Mateushga1/Buck-Boost-Converter/Readme.md

# 8V–56V Selectable Buck–Boost/Buck Regulator with Opto-Isolated 0V-5V/4mA-20mA Control Signal

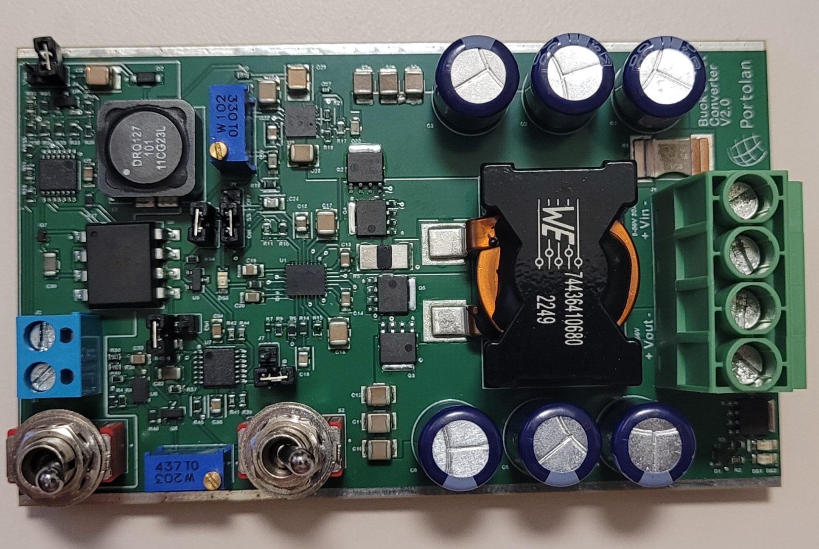
[picture p1: Manual/figures/PCB_Real.jpg]
PCB Image
