Mateushga1/Buck-Boost-Converter/_deprecated-V1/Simulation_Buck_Boost.pdf

# Projet Portolan

### Données de Simulation du Convertisseur Buck-Boost

### Mateus GALVÃO

Janvier 2024

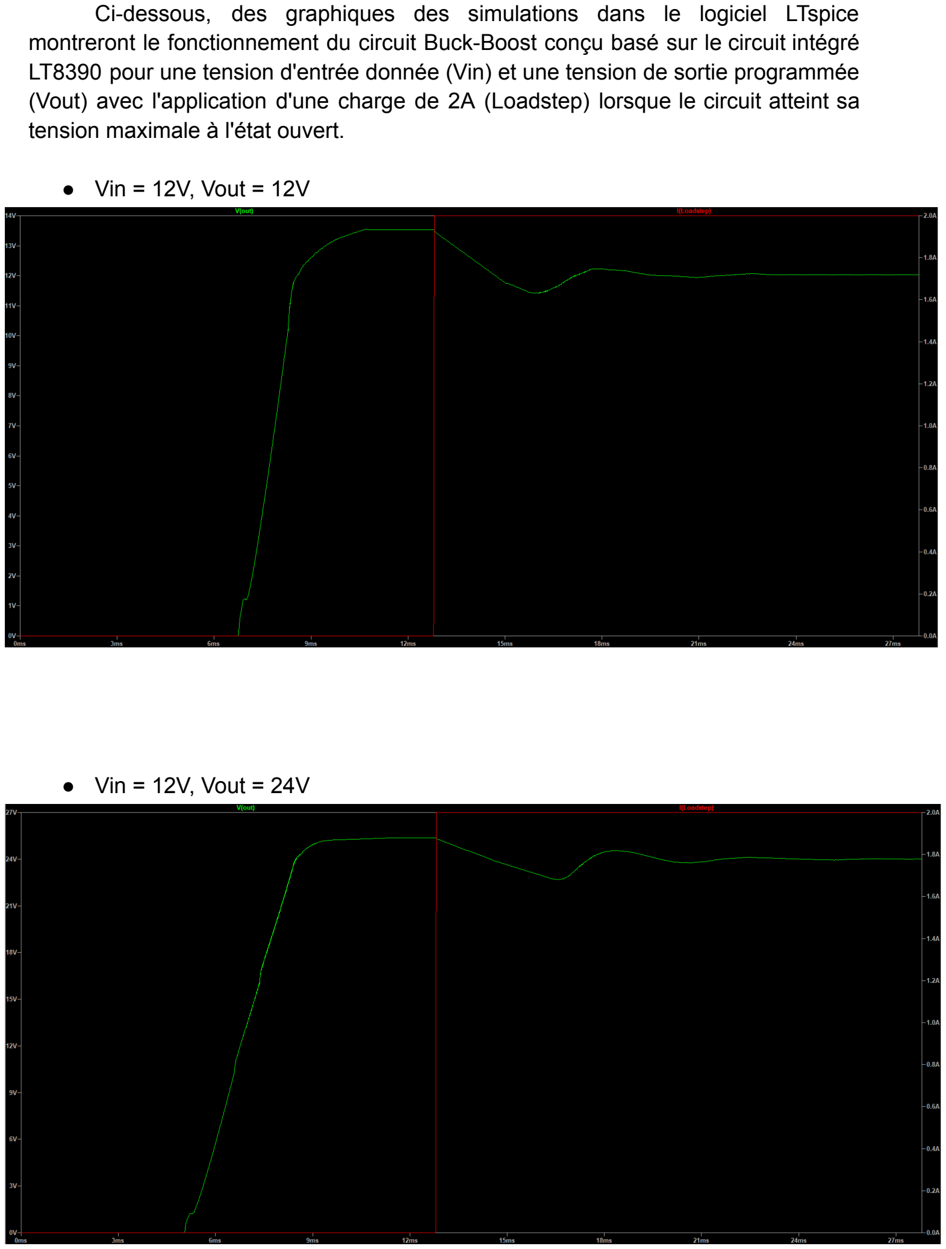
[picture p9: page 2]

Ci-dessous, des graphiques des simulations dans le logiciel LTspice montreront le fonctionnement du circuit Buck-Boost conçu basé sur le circuit intégré LT8390 pour une tension d'entrée donnée (Vin) et une tension de sortie programmée (Vout) avec l'application d'une charge de 2A (Loadstep) lorsque le circuit atteint sa tension maximale à l'état ouvert.

- Vin = 12V, Vout = 12V
- Vin = 12V, Vout = 24V

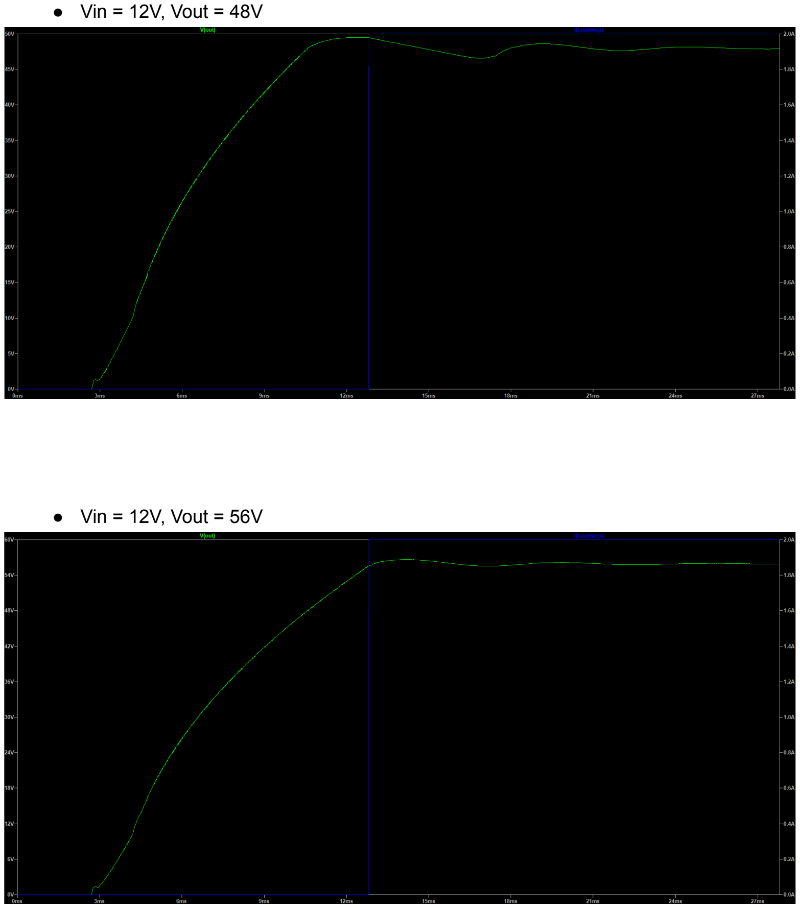
[picture p10: page 3]

- Vin = 12V, Vout = 48V
- Vin = 12V, Vout = 56V

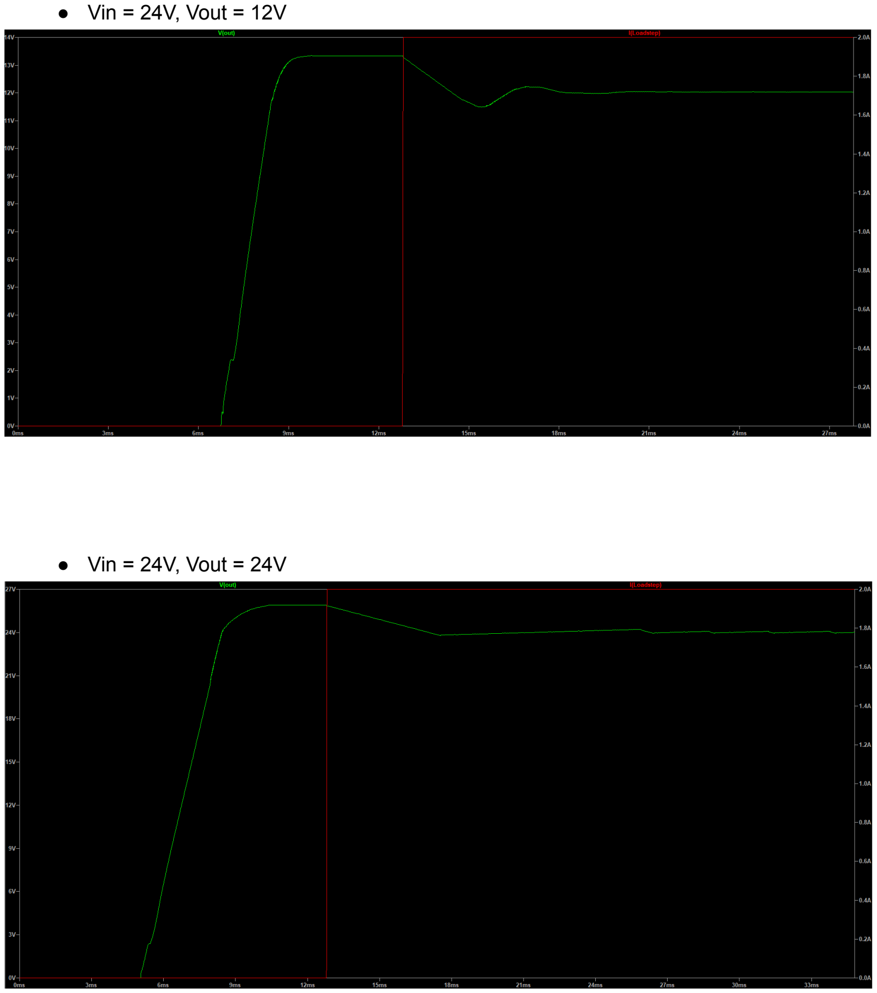
[picture p11: page 4]

- Vin = 24V, Vout = 12V
- Vin = 24V, Vout = 24V

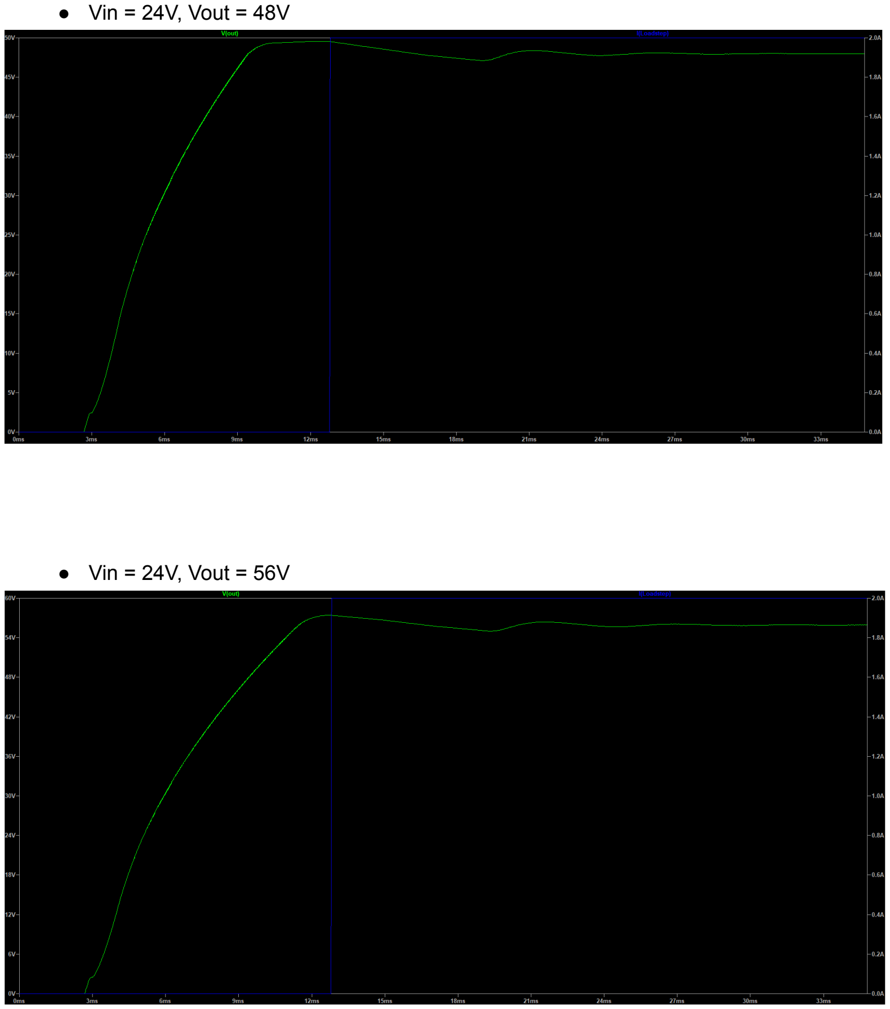
[picture p12: page 5]

- Vin = 24V, Vout = 48V
- Vin = 24V, Vout = 56V

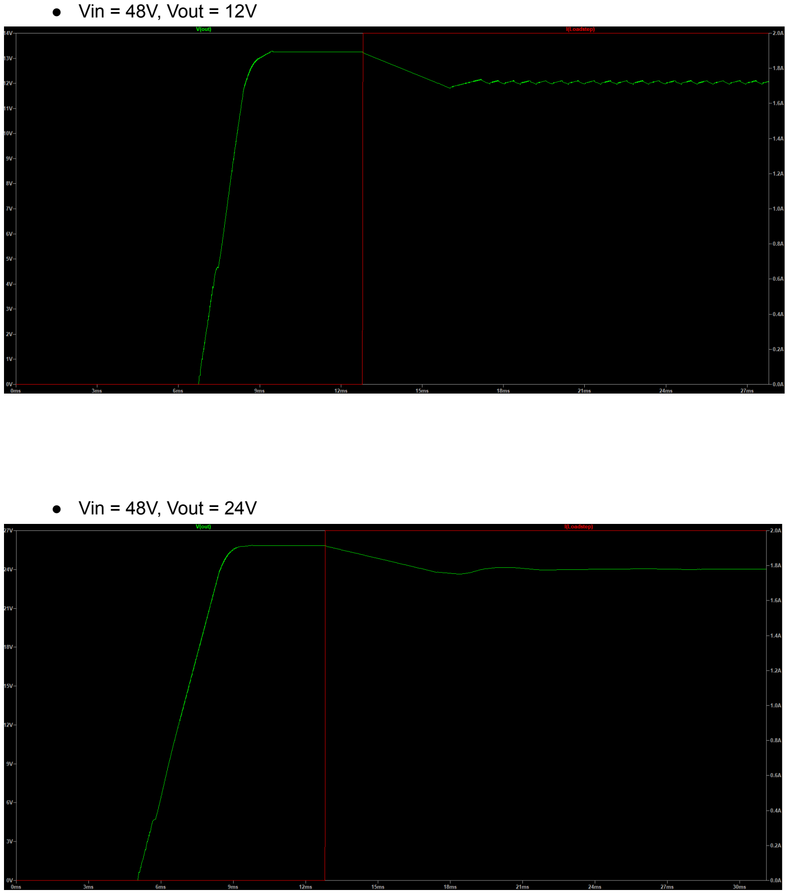
[picture p13: page 6]

- Vin = 48V, Vout = 12V
- Vin = 48V, Vout = 24V

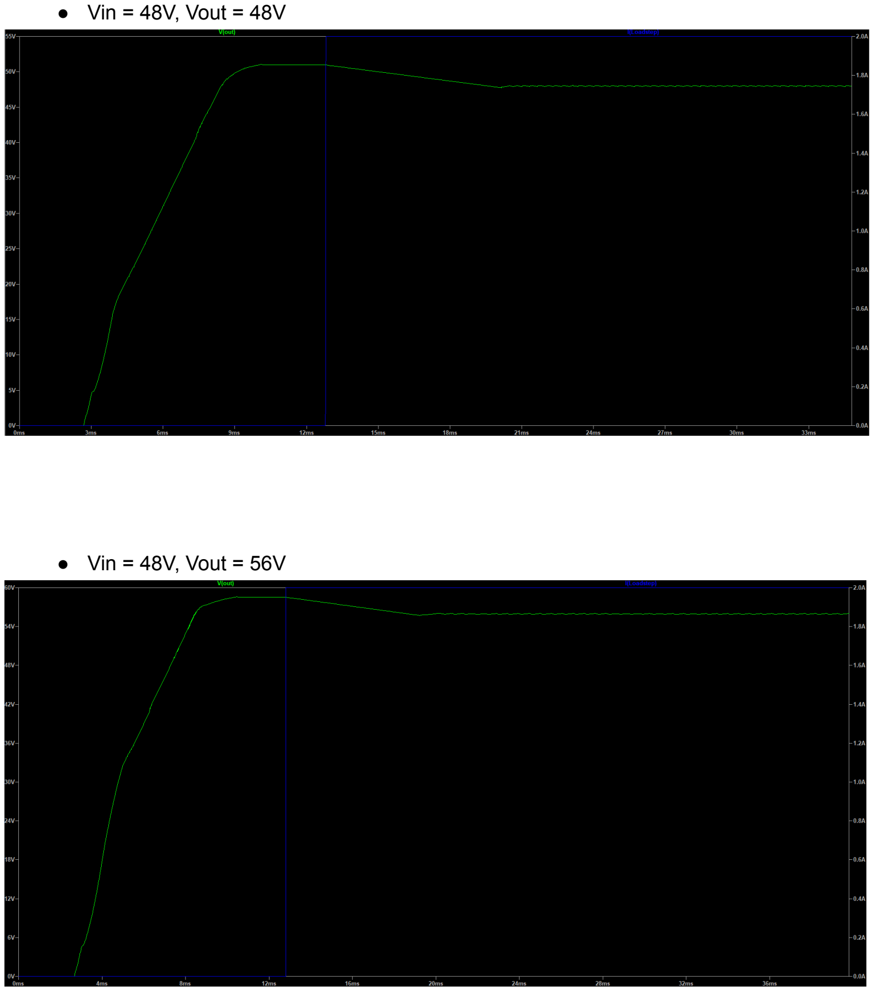
[picture p14: page 7]

- Vin = 48V, Vout = 48V
- Vin = 48V, Vout = 56V

La table ci-dessous présente le taux d'efficacité dans chacune des situations simulées:
