Mateushga1/Buck-Boost-Converter/PCB-V2.jpg

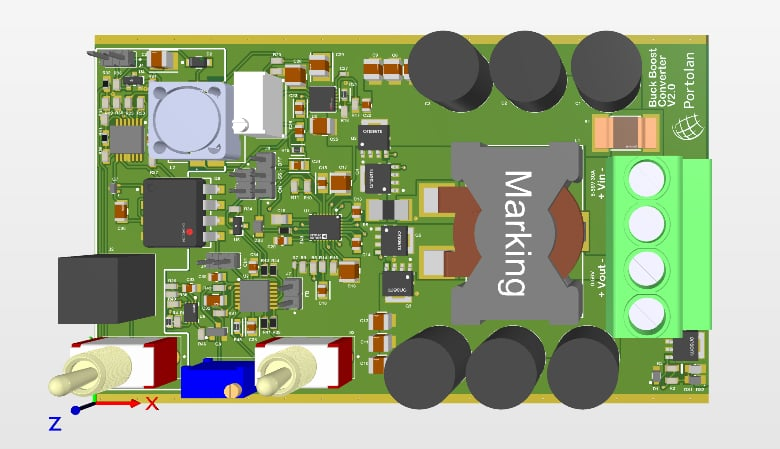
PCB-V2.jpg
