Mateushga1/Buck-Boost-Converter/T-Y10W732956A-1sets-BOM_Portolan_Buck_Boost_V2(2024-12-02).xls

PCBWay Bom Quotation, Product No.:T-Y10W732956A
Item # | *Designator | *Qty | Manufacturer | *Mfg Part # | Description / Value | Vendor Part # | *Package/Footprint | Mounting Type | *Unit Price(1 set) | *Total | *Delivery Time | *PCBWay Note | Customer Reply
1 | C1, C2, C3, C4, C5, C6 | 6 | Panasonic | ECA-2AM101 | ECA-2AM101B『 』Aluminium Electrolytic Capacitors 100uF 100V - Radial Leaded Al Lytic Cap 85C Radial M Series | Farnell『 』9693947 | CAPPRD500W65D1025H1700 | Through Hole | $0.420 | $2.520
2 | C7, C8, C9, C10, C11, C12 | 6 | Murata | GRM32EC72A106KE05L | GRM32EC72A106KE05L『 』Chip Multilayer Ceramic Capacitors for General Purpose, 1210, 10uF, X7S, 22%, 10%, 100V | Farnell『 』3790455 | FP-GRM32E-0_3-0_2-MFG | Surface Mount, MLCC | $0.701 | $4.206
3 | C13, C14, C20, C26, C31, C33, C34, C35 | 8 | Kyocera AVX | 08055C104JAT2A | 08055C104JAT2A『 』General Purpose Ceramic Capacitor, 0805, 100nF, 5%, X7R, 0.15, 50V | Farnell『 』1740673 | 0805 (2012 Metric)『 』FP-0805-L_2_01_0_2-W_1_25-MFG | Surface Mount, MLCC | $0.139 | $1.112
4 | C15 | 1 | KEMET | C0805C475K8PAC | 0805ZD475KAT2A『 』General Purpose Ceramic Capacitor, 0805, 4.7uF, 10%, X5R, 0.15, 10V | Mouser『 』80-C0805C475K8PAC | FP-0805-L_2_01_0_2-W_1_25-IPC_A |  | $0.147 | $0.147
5 | C16, C17, C25, C28 | 4 | Kyocera AVX | 12101C105KAT2A | 12101C105KAT2A『 』General Purpose Ceramic Capacitor, 1210, 1uF, 10%, X7R, 15%, 100V | Farnell『 』1301814 | 1210 (3225 Metric)『 』FP-1210-L_3_3_0_4-W_2_5_0-IPC_C | Surface Mount, MLCC | $0.504 | $2.016
6 | C18, C23, C36 | 3 | Kyocera AVX | 08055C103JAT2A | 08055C103JAT2A『 』General Purpose Ceramic Capacitor, 0805, 10nF, 5%, X7R, 0.15, 50V | Mouser『 』581-08055C103J | 0805 (2012 Metric)『 』FP-0805-L_2_01_0_2-W_1_25-IPC_B | Surface Mount, MLCC | $0.139 | $0.417
7 | C19 | 1 | Kyocera AVX | 08055C474JAT2A | 08055C474JAT2A | Mouser『 』581-08055C474JAT2A | CAPC2013X140X50ML20T25 |  | $0.139 | $0.139
8 | C21, C29 | 2 | Murata | GRM32EC81C476KE15K | GRM32EC81C476KE15K『 』Chip Multilayer Ceramic Capacitors for General Purpose, 1210, 47uF, X6S, 22%, 10%, 16V | Mouser『 』81-GRM32EC81C476KE5K | FP-GRM32E-0_3-0_2-IPC_A |  | $0.488 | $0.976
9 | C22 | 1 | Murata | GRM21AR72A224KAC5L | GRM21AR72A224KAC5L『 』CAP CER 0.22UF 100V X7R 0805 | Digikey『 』490-6461-1-ND | 0805 (2012 Metric)『 』FP-GRM21A-0_1-MFG | Surface Mount, MLCC | $0.164 | $0.164
10 | C24 | 1 | Murata | GRM2195C1H512JA01D | GRM2195C1H512JA01D『 』Chip Multilayer Ceramic Capacitors for General Purpose, 0805, 5100pF, C0G, 30ppm/°C, 5%, 50V | Mouser『 』81-GRM2195C1H512JA1D | 0805 (2012 Metric)『 』FP-GRM219-0_1-IPC_A | Surface Mount, MLCC | $0.521 | $0.521 | 7-10 Workdays
11 | C27 | 1 | Kyocera AVX | 0402YD273KAT2A | 0402YD273KAT2A | Digikey『 』478-1122-1-ND | 0402 (1005 Metric)『 』CAPC1005X56X25LL10T15 | Surface Mount, MLCC | $0.172 | $0.172
12 | C30, C32 | 2 | Kyocera AVX | 12061A102JAT2A | 12061A102JAT2A『 』General Purpose Ceramic Capacitor, 1206, 1nF, 5%, NP0, 30ppm/°C, 100V | Mouser『 』581-12061A102J | 1206 (3216 Metric)『 』FP-1206-L_3_2_0_2-W_1_6_0-IPC_C | Surface Mount, MLCC | $0.189 | $0.378
13 | D1 | 1 | ON Semiconductor | MM3Z10VST1G | MM3Z10VST1G『 』Zener Voltage Regulator, 300 mW, Tight Tolerance Portfolio, 2-Pin SOD-323, Pb-Free, Tape and Reel | Mouser『 』863-MM3Z10VST1G | ONSC-SOD-323-2-477-02_V | Surface Mount | $0.042 | $0.042
14 | D2 | 1 | ON Semiconductor | MBR230LSFT1G | MBR230LSFT1G『 』DIODE SCHOTTKY 30V 2A SOD123L | Mouser『 』863-MBR230LSFT1G | FP-498-MFG | Surface Mount | $0.157 | $0.157
15 | DS1 | 1 | Vishay Lite-On | LTST-C170KRKT | LTST-C170KRKT『 』LED Red, 75 mW, 54 mcd, -55 to 85 degC, 2-Pin SMD, RoHS, Tape and Reel | Digikey『 』160-1415-1-ND | LTST-C170KRKT_V | Surface Mount | $0.586 | $0.586
16 | DS2, DS3 | 2 | Vishay Lite-On | LTST-C170KGKT | LTST-C170KGKT『 』Ultra Bright AlInGaP Chip LED, 75 mW, -55 to 85 degC, 2-Pin SMD (0805), RoHS, Tape and Reel | Mouser『 』859-LTST-C170KGKT | LTST-LTST-C170KGKT-2_V |  | $0.019 | $0.038
17 | J1 | 1 | Phoenix Contact | 1777561 | 1777561『 』Connector | Mouser『 』651-1777561 | 1777561 | Through Hole | $5.551 | $5.551 | 7-10 Workdays
18 | J2 | 1 | CUI Devices | TB001-500-02BE | TB001-500-02BE『 』Integrated Circuit | Mouser『 』490-TB001-500-02BE | TB00150002BE | Through Hole | $0.846 | $0.846 | 7-10 Workdays
19 | J3 | 1 | Molex | 22-28-4030 | 22-28-4030『 』Connector Header Through Hole 3 position 0.100 (2.54mm) | Mouser『 』538-22-28-4030 | MOLEX_22-28-4030 |  | $0.320 | $0.320 | 7-10 Workdays
20 | J4, J5, J6, J7 | 4 | Molex | 22-28-4020 | 22-28-4020『 』Connector Header Through Hole 2 position 0.100 (2.54mm) | Farnell『 』2751448 | MOLEX_22-28-4020 |  | $0.222 | $0.888 | 7-10 Workdays
21 | L1 | 1 | Wurth Electronics | 74436410680 | 74436410680『 』74436410680 Inductor, high current, 6.8uH, 1.44mOhm, 27mmL x 28mmW x 15.4mmH, SMT | Wurth Electronics 74436410680 | Digikey『 』732-11532-ND | WE-HCF_2815 | Surface Mount | $9.997 | $9.997
22 | L2 | 1 | Eaton Bussmann | DRQ127-101-R | DRQ127-101-R『 』Inductor | Mouser『 』704-DRQ127-101-R | DRQ127101R | Surface Mount | $2.029 | $2.029 | 7-10 Workdays
23 | Q1, Q2, Q3, Q4, Q5 | 5 | ON Semiconductor | NVMYS3D3N06CLTWG | NVMYS3D3N06CLTWG『 』NVMYS3D3N06CLTWG Single Mosfet Transistors Rohs Compliant: Yes |Onsemi NVMYS3D3N06CLTWG | Mouser『 』863-NVMYS3D3N06CLTWG | FP-760AB-MFG | Surface Mount | $1.858 | $9.290 | 7-10 Workdays
24 | Q6 | 1 | Broadcom Avago | HCNR200-500E | HCNR200-500E『 』OPTOISO 5KV LINEAR PHVOLT 8DIPGW | Mouser『 』630-HCNR200-500E | FP-HCNR200-500E-MFG | Surface Mount | $1.570 | $1.570
25 | Q7 | 1 | ON Semiconductor | MMBT3906TT1G | MMBT3906TT1G『 』General Purpose Transistor, PNP Silicon, 3-Pin SC-75, Pb-Free, Tape and Reel | Digikey『 』MMBT3906TT1GOSCT-ND | ONSC-SC-75-3-463-01_V | Surface Mount | $0.050 | $0.050
26 | Q8 | 1 | ON Semiconductor | MMBT3904LT1G | MMBT3904LT1G『 』General Purpose Transistor, NPN Silicon, 3-Pin SOT-23, Pb-Free, Tape and Reel | Mouser『 』863-MMBT3904LT1G | ONSC-SOT-23-3-318-08_V | Surface Mount | $0.454 | $0.454
27 | R1 | 1 | Bourns | CSS2H-3920K-3L00FE | CSS2H-3920K-3L00FE『 』RES 0.003 OHM 1% 5W 3920 | Farnell『 』4036977 | FP-CSS2H-3920K-3L00FE-MFG |  | $1.764 | $1.764 | 7-10 Workdays
28 | R2 | 1 | Yageo | RC0603FR-073K32L | ERJ-3EKF3321V | Mouser『 』603-RC0603FR-073K32L | 0603 (1608 Metric)『 』RESC1608X55X30NL15T15 |  | $0.152 | $0.152 |  | The quoted part number is [RC0603FR-073K32L], not [ERJ-3EKF3321V] as specified in description.Please confirm. | The part number is correct, you can disconsider the description
29 | R3, R15, R23, R25, R26, R29, R30 | 7 | Panasonic | ERJ-3EKF1003V | ERJ-3EKF1003V | Mouser『 』667-ERJ-3EKF1003V | 0603 (1608 Metric)『 』RESC1608X55X30ML15T15 |  | $0.046 | $0.322
30 | R4 | 1 | Panasonic | ERJ-3EKF1873V | ERJ-3EKF1873V『 』RES SMD 187K OHM 1% 1/10W 0603 | Digikey『 』P187KHCT-ND | 0603 (1608 Metric)『 』FP-ERJ3EK-MFG |  | $0.046 | $0.046
31 | R5 | 1 | Vishay | WSLP25121L600FEA | WSLP25121L600FEA『 』Current Sense Resistors - SMD 3watt .0016ohm 1% | Mouser『 』71-WSLP25121L600FEA | 2512 (6432 Metric)『 』RESC6432X89N |  | $1.373 | $1.373 | 7-10 Workdays
32 | R6 | 1 | Panasonic | ERJ-3EKF8203V | ERJ3EKF8203V | Mouser『 』667-ERJ-3EKF8203V | 0603 (1608 Metric)『 』RESC1608X55X30ML15T15 |  | $0.046 | $0.046
33 | R7 | 1 | Panasonic | ERJ-2RKF7322X | ERJ-2RKF7322X | Mouser『 』667-ERJ-2RKF7322X | 0402 (1005 Metric)『 』RESC1005X40X25LL05T05 |  | $0.046 | $0.046
34 | R8 | 1 | Panasonic | ERJ-3EKF3401V | ERJ-3EKF3401V | Digikey『 』P3.40KHCT-ND | 0603 (1608 Metric)『 』RESC1608X55X30LL15T15 |  | $0.046 | $0.046
35 | R9 | 1 | Panasonic | ERJ-3EKF1872V | ERJ-3EKF1872V | Mouser『 』667-ERJ-3EKF1872V | 0603 (1608 Metric)『 』RESC1608X55X30LL15T15 |  | $0.046 | $0.046
36 | R10 | 1 | Panasonic | ERJ-3EKF2493V | ERJ-3EKF2493V | Digikey『 』P249KHCT-ND | 0603 (1608 Metric)『 』RESC1608X55X30ML15T15 |  | $0.046 | $0.046
37 | R11 | 1 | Bourns | CR0603-FX-4532ELF | ERJ-3EKF4532V | Mouser『 』652-CR0603-FX4532ELF | 0603 (1608 Metric)『 』RESC1608X55X30ML15T15 |  | $0.042 | $0.042 |  | The quoted part number is [CR0603-FX-4532ELF], not [ERJ-3EKF4532V] as specified in description.Please confirm. | The part number is correct, you can disconsider the description
38 | R12 | 1 | Panasonic | ERJ-3EKF3300V | ERJ-3EKF3300V『 』Chip Resistor, 330 Ohm, +/- 1%, 0.1 W, -55 to 155 degC, 0603 (1608 Metric), RoHS, Tape and Reel | Mouser『 』667-ERJ-3EKF3300V | 0603 (1608 Metric)『 』RESC1608X55X30LL15T15 |  | $0.046 | $0.046
39 | R14 | 1 | Panasonic | ERJ-3EKF2201V | ERJ3EKF2201V | Mouser『 』667-ERJ-3EKF2201V | 0603 (1608 Metric)『 』RESC1608X55X30LL15T15 |  | $0.046 | $0.046
40 | R17 | 1 | Yageo | RC0603FR-07162KL | ERJ-3EKF1623V | Digikey『 』311-162KHRCT-ND | 0603 (1608 Metric)『 』RESC1608X55X30ML15T15 |  | $0.154 | $0.154 |  | The quoted part number is [RC0603FR-07162KL], not [ERJ-3EKF1623V] as specified in description.Please confirm. | The part number is correct, you can disconsider the description
41 | R18 | 1 | Panasonic | ERJ-3EKF1333V | ERJ-3EKF1333V | Digikey『 』P133KHCT-ND | 0603 (1608 Metric)『 』RESC1608X55X30LL15T15 |  | $0.042 | $0.042
42 | R19 | 1 | Panasonic | ERJ-3EKF1302V | ERJ-3EKF1302V『 』RES SMD 13K OHM 1% 1/10W 0603 | Digikey『 』P13.0KHCT-ND | 0603 (1608 Metric)『 』FP-ERJ3EK-IPC_C |  | $0.042 | $0.042
43 | R20 | 1 | Bourns | CR0603-FX-3571ELF | ERJ-3EKF3571V | Mouser『 』652-CR0603FX-3571ELF | 0603 (1608 Metric)『 』RESC1608X55X30LL15T15 |  | $0.042 | $0.042
44 | R21 | 1 | Panasonic | ERJ-3EKF2372V | ERJ-3EKF2372V『 』RES SMD 23.7K OHM 1% 1/10W 0603 | Digikey『 』P23.7KHCT-ND | 0603 (1608 Metric)『 』FP-ERJ3EK-IPC_C |  | $0.046 | $0.046
45 | R22 | 1 | Panasonic | ERJ-3EKF2001V | ERJ-3EKF2001V | Digikey『 』P2.00KHCT-ND | 0603 (1608 Metric)『 』RESC1608X55X30ML15T15 |  | $0.046 | $0.046
46 | R24 | 1 | Panasonic | ERJ-3EKF2002V | ERJ-3EKF2002V | Digikey『 』P20.0KHCT-ND | 0603 (1608 Metric)『 』RESC1608X55X30ML15T15 |  | $0.046 | $0.046
47 | R27 | 1 | Panasonic | ERJ-3EKF1500V | ERJ-3EKF1500V | Digikey『 』P150HCT-ND | 0603 (1608 Metric)『 』RESC1608X55X30NL15T15 |  | $0.046 | $0.046
48 | R28 | 1 | Panasonic | ERJ-3EKF5111V | ERJ-3EKF5111V | Mouser『 』667-ERJ-3EKF5111V | 0603 (1608 Metric)『 』RESC1608X55X30LL15T15 |  | $0.046 | $0.046
49 | R31, R32 | 2 | Yageo | RT0603BRE07250RL | 250R『 』Thin Film Resistors - SMD 250 ohm 0.1% 50 ppm High-Precision RT0603BRE07250RL | Digikey『 』13-RT0603BRE07250RLCT-ND | 0603 (1608 Metric)『 』RESC1608X55N |  | $0.147 | $0.294
50 | R33, R43, R46 | 3 | Panasonic | ERJ-3EKF1001V | ERJ-3EKF1001V | Mouser『 』667-ERJ-3EKF1001V | 0603 (1608 Metric)『 』RESC1608X55X30LL15T15 |  | $0.046 | $0.138
51 | R34, R35 | 2 | Panasonic | ERJ-3EKF7680V | ERJ-3EKF7680V | Mouser『 』667-ERJ-3EKF7680V | 0603 (1608 Metric)『 』RESC1608X55X30LL15T15 |  | $0.046 | $0.092
52 | R36 | 1 | Yageo | RC0603FR-071ML | RC0603FR-071ML『 』Chip Resistor, 1 MOhm, +/- 1%, 100 mW, -55 to 155 degC, 0603 (1608 Metric), RoHS, Tape and Reel | Digikey『 』311-1.00MHRCT-ND | 0603 (1608 Metric)『 』RESC1608X55X25LL10T15 |  | $0.154 | $0.154
53 | R37 | 1 | Panasonic | ERJ-3EKF9092V | ERJ-3EKF9092V | Digikey『 』P90.9KHCT-ND | 0603 (1608 Metric)『 』RESC1608X55X30ML15T15 |  | $0.046 | $0.046
54 | R38 | 1 | Bourns | CR0603-FX-2803ELF | ERJ-3EKF2803V | Mouser『 』652-CR0603-FX2803ELF | 0603 (1608 Metric)『 』RESC1608X55X30LL15T15 |  | $0.042 | $0.042 |  | The quoted part number is [CR0603-FX-2803ELF], not [ERJ-3EKF2803V] as specified in description.Please confirm. | The part number is correct, you can disconsider the description
55 | R39, R41, R42, R44 | 4 | Bourns | CR0603-FX-1002ELF | ERJ3EKF1002V『 』Chip Resistor, 10 KOhm, +/- 1%, 0.1 W, -55 to 155 degC, 0603 (1608 Metric), RoHS, Tape and Reel | Mouser『 』652-CR0603FX-1002ELF | 0603 (1608 Metric)『 』RESC1609X55X30LL15T15 |  | $0.042 | $0.168 |  | The quoted part number is [CR0603-FX-1002ELF], not [ERJ3EKF1002V] as specified in description | The part number is correct, you can disconsider the description
56 | R40 | 1 | Panasonic | ERJ-3EKF7502V | ERJ-3EKF7502V | Digikey『 』P75.0KHCT-ND | 0603 (1608 Metric)『 』RESC1608X55X30NL15T15 |  | $0.046 | $0.046
57 | R45 | 1 | Panasonic | ERJ-3EKF4993V | ERJ-3EKF4993V『 』RES SMD 499K OHM 1% 1/10W 0603 | Digikey『 』P499KHCT-ND | FP-ERJ3EK-IPC_B |  | $0.046 | $0.046
58 | S1, S2 | 2 | E-Switch | 100SP1T1B1M2QEH | 100SP1T1B1M2QEH『 』Switch | Farnell『 』4050975 | 100SP1T1B4M2QE |  |  |  |  | [DNP不要贴]; | You can leave it without the part, I can solder it when the PCB arrives
59 | U1 | 1 | Analog Devices / Linear Technology | LT8390EUFD#PBF | LT8390EUFD#PBF『 』IC REG CTRLR BUCK/BOOST 28QFN | Farnell『 』4026327 | FP-UFD-28-05-08-1712-MFG | Surface Mount | $17.265 | $17.265 | 7-10 Workdays
60 | U2 | 1 | Texas Instruments | LM5160DNTT | LM5160DNTT『 』IC REG BCK FLYBCK ADJ 12WSON | Digikey『 』296-38543-1-ND | FP-DNT0012B-MFG | Surface Mount | $2.516 | $2.516
61 | U3, U7 | 2 | Analog Devices | AD8534ARUZ-REEL | AD8534ARUZ-REEL『 』Quad Channel Rail-to-Rail Operational Amplifier, 3 MHz BW, 5 V/us SR, Industrial, 14-pin SOP (RU-14), Reel | Farnell『 』4019796 | ADI-RU-14_L | Surface Mount | $1.688 | $3.376
62 | U4, U5 | 2 | Microchip | LM4040CYM3-5.0-TR | LM4040CYM3-5.0-TR『 』LM4040CYM3-5.0-TR LM4040 Series 5 V ±0.5% Precision Micropower Shunt Voltage Reference-SOT-23-3 | Farnell『 』2775054 | FP-SOT23-3LD-PL-1-MFG | Surface Mount | $0.683 | $1.366
63 | U6 | 1 | Analog Devices / Linear Technology | LTC6992CDCB-1#TRMPBF | LTC6992CDCB-1#TRMPBF『 』IC OSC SILICON PROG 6-DFN | Farnell『 』4023646 | FP-DCB-6-05-08-1715-MFG | Surface Mount | $7.328 | $7.328 | 7-10 Workdays | The quoted part number is [LTC6992CDCB-1#TRMPBF], not [PROG] as specified in description | The part number is correct, you can disconsider the description
64 | VR1 | 1 | Bourns | 3296W-1-102LF | 3296W-1-102LF『 』Square Trimpot(R) Trimming Potentiometer, 1000 Ohm, -55 to 125 degC, 3-Pin THD, RoHS, Tube | Mouser『 』652-3296W-1-102LF | BOUR-3296W-1-3 | Through Hole | $0.856 | $0.856
65 | VR2 | 1 | Bourns | 3296W-1-203LF | 3296W-1-203LF『 』Trimmer Resistors - Through Hole 3/8 20Kohms Sealed Vertical Adjust | Mouser『 』652-3296W-1-203LF | TRIM_3296W-1-203LF |  | $0.801 | $0.801
66 | J3,J4,J5,J6,J7 | 5 |  | QPC02SXGN-RC | 2 (1 x 2) Position Shunt Connector Black Open Top 0.100" (2.54mm) Gold |  |  |  | $0.159 | $0.795 | 7-10 Workdays | 5pcs QPC02SXGN-RC will be used on this board.
 |  |  |  |  |  |  |  |  | Component Cost | $84.45
 |  |  |  |  |  |  |  |  | Assembly Cost | $29.00
 |  |  |  |  |  |  |  |  | PCB Cost | $0.00
 |  |  |  |  |  |  |  |  | V1 Member 1% off | -$0.29
 |  |  |  |  |  |  |  |  | All Total 1 Sets | $113.16
 |  |  |  |  |  |  |  |  | lead time; 26-28 days
