Mateushga1/Buck-Boost-Converter/Manual/BuckBoost.pdf

LT8390 | Regulateur s ´ | electionnable Buck-Boost ´
a commande opto-isol ` | ee´

Description Gen´ erale ´

Ce projet presente la conception et ´ la realisation d’une carte convertisseur ´ DC-DC compacte et haute performance,
basee sur le contr ´ | oleur synchrone ˆ | a 4 in- `
terrupteurs LT8390 de Linear Technology. La carte accepte une large plage de tensions d’entree (8 V-56 V) et fournit une ´
sortie reglable de 0 V ´ | a 56 V en mode `
Buck-Boost ou jusqu’a Vin en mode Buck, ` avec controle de courant cycle-par-cycle ˆ
jusqu’a 30 A en entr ` | ee et rendements de ´
crete sup ˆ | erieurs ´ | a 93 %. `

Les blocs fonctionnels cles comprennent : ´
une etage Buck-Boost int ´ | egr ´ e, une protec- ´
tion contre l’inversion de polarite´ a base ` de MOSFET, un convertisseur auxiliaire Fly-Buck (LM5160A) fournissant des rails
5 V isoles et non isol ´ | es, une interface ´
de controle externe galvanique isol ˆ | ee (0- ´
5 V ou 4-20 mA) basee sur l’optocoupleur ´ HCNR200, et un reseau programmable ´ de selection de mode et d’injection de ´ retroaction (utilisant un PWM LTC6992 ´ pour l’echelle Buck). ´

Le cycle complet de developpement a ´
et ´ e r ´ ealis ´ | e : d ´ | efinition de la topologie et ´
dimensionnement des composants selon les datasheets, modelisation LTspice, im- ´ plantation du PCB sous Altium, et validation en banc des etages de puissance et ´ des boucles de controle. ˆ

Avantages et Caracteristiques ´

- Plage de tension d’entree´ etendue (8V- ´ 56V).
- Topologie | synchrone | 4 | interrupteurs
LT8390.
- Rendement ¡ 93%.
- Protection contre inversion de polarite par ´ MOSFET avec indication LED visuelle.
- Convertisseur auxiliaire Fly-Buck four-
nissant des rails 5 V isoles et non isol ´ | es. ´
- Controle externe galvanique isol ˆ | e via op- ´
tocoupleur haute linearit ´ | e.´
- Interface | de | commande | externe
selectionnable (0-5 V ou 4-20 mA). ´
- Selection dynamique du mode entre ´ Buck-Boost (0 V-56 V en sortie) et Buck (0 V-Vin en sortie).
- Limitation de courant cycle-par-cycle
(resistance de d ´ | etection 1,6 m ´ | Ω), UVLO
(¡ 8 V) et demarrage progressif pour ´ protection robuste.
- Modulation de frequence ´ | a Spread Spec- `
trum pour reduire les EMI. ´
- PCB compact 2 couches a haute densit ` | e´
de composants.

Revision 1 - Juin 2025 ´

## 1 Outils Utilises´

Pour le developpement complet de ce projet, trois outils principaux ont ´ | et´ e utilis ´ | es´
: LTspice, LTpowerCAD et Altium Designer. Chacun d’eux joue un role fondamental ˆ | a`
differentes ´ | etapes du processus de cr ´ | eation, depuis la simulation et le dimensionnement ´
initial des composants jusqu’a l’ ` elaboration des sch ´ | emas et du circuit imprim ´ | e (PCB). ´
LTspice est un simulateur SPICE de circuits electroniques gratuit, fourni par Analog ´ Devices. Il permet de modeliser des transistors, diodes, inductances, condensateurs et ´
de nombreux autres composants electroniques, en r ´ | ealisant des analyses dans le do- ´
maine temporel (transitoires), frequentiel (balayage AC) et en point de fonctionnement ´
(point DC), entre autres. Dans le cadre de ce projet, LTspice a et´ e utilis ´ | e pour simuler ´
tous les sous-circuits conc¸us. Grace ˆ | a ces simulations, il a ` | et´ e possible d’observer les ´
formes d’onde de commutation, d’analyser les ondulations de tension et de courant, d’estimer les rendements et de valider les circuits de protection avant l’assemblage
physique de la carte. L’outil a egalement facilit ´ | e l’ajustement des valeurs des induc- ´
tances, resistances de d ´ | etection et fr ´ | equences de commutation, rendant le processus de ´
dimensionnement plus efficace et precis. La simulation a permis d’identifier d’ ´ | eventuels ´
problemes de stabilit ` | e et de bruit, permettant ainsi des ajustements avant la fabrication ´
du prototype. Cependant, elle ne permet pas de valider les protections contre les in-
terferences ´ | electromagn ´ | etiques (EMI) et la compatibilit ´ | e´ electromagn ´ | etique (EMC), qui ´
sont extremement difficiles ˆ | a` evaluer sans la r ´ | ealisation physique du circuit. ´
LTpowerCAD est un logiciel d’aide a la conception de r ` | egulateurs de puissance, ´
egalement propos ´ | e par Analog Devices. Cet outil automatise le dimensionnement initial ´
des convertisseurs DC/DC, en suggerant des valeurs pour les inductances, conden- ´
sateurs, MOSFETs et resistances de r ´ | etroaction en fonction des param ´ | etres d’entr ` | ee´
(tension d’alimentation, tension de sortie desir ´ | ee, courant de charge, fr ´ | equence de ´
commutation, entre autres). Pour le convertisseur buck-boost principal, LTpowerCAD
a et ´ e utilis ´ | e pour g ´ | en´ erer une conception de base, en d ´ | efinissant des valeurs approx- ´
imatives d’inductance, de capacite et de composants de contr ´ | ole recommand ˆ | es par le ´
fabricant du LT8390. A partir de cette base, les param ` | etres ont ` | et´ e affin ´ | es dans LTspice, ´
garantissant que les aspects theoriques et pratiques du projet respectaient les crit ´ | eres `
d’efficacite, de stabilit ´ | e et de robustesse d ´ | efinis dans la fiche technique. ´
Enfin, Altium Designer a et ´ e l’outil choisi pour le d ´ | eveloppement du sch ´ | ema com- ´
plet et de la carte de circuit imprime (PCB). Altium Designer est un environnement de ´
conception assistee par ordinateur (CAO) d ´ | edi ´ e´ a l’ ` electronique, permettant de dessiner ´
les schemas, cr ´ | eer des biblioth ´ | eques de composants, d ` | efinir les r ´ | egles de conception `
(design rules) et realiser des layouts de cartes avec des fonctions avanc ´ | ees de routage, ´
d’analyse d’integrit ´ | e du signal et de v ´ | erification d’imp ´ | edance. Dans le cadre de ce projet, ´
Altium Designer a permis la capture schematique de tous les sous-circuits, la connex- ´ ion des signaux d’alimentation et de commande, l’insertion de composants specifiques ´ (LT8390, LM5160A, optocoupleurs, MOSFETs, etc.), et ensuite la gen´ eration du PCB ´ avec un empilement de couches approprie, la d ´ efinition des vias, des plans de cuivre ´

pour l’alimentation et des zones de masse optimisees. De plus, Altium a g ´ | en´ er´ e les ´
fichiers de fabrication (Gerber, NC Drill et listes de materiaux) n ´ | ecessaires ´ | a la produc- `
tion du prototype, assurant que le projet respecte les bonnes pratiques de routage et les exigences de fabrication industrielle.

## 2 Sous-circuits

Dans cette section, sont present ´ | es les principaux blocs qui composent la carte : (1) ´
le convertisseur Buck-Boost base sur le LT8390, charg ´ | e de la conversion DC/DC de ´
la tension d’entree vers la tension de sortie d ´ | esir ´ | ee , (2) le circuit de protection con- ´
tre l’inversion de polarite, qui emp ´ | eche tout dommage si les c ˆ | ables d’alimentation sont ˆ
inverses , (3) le convertisseur Fly-Buck, qui g ´ | en´ ere les alimentations 5 V n ` | ecessaires ´
aux circuits de commande, tant en zones isolee que non isol ´ | ee , (4) le circuit de signal ´
de commande externe isole, qui rec¸oit et conditionne des signaux 0-5 V ou 4-20 mA ´
de maniere galvanis ` | ee isol ´ | ee , et (5) le circuit de commande et de s ´ | election de mode, ´
charge d’adapter et d’injecter le signal de commande dans la boucle de r ´ | etroaction du ´
LT8390, permettant de choisir entre les modes Buck et Buck-Boost et d’ajuster la tension
de sortie selon la valeur du signal externe. Chaque sous-circuit sera detaill ´ | e ci-apr ´ | es, `
presentant son principe de fonctionnement, le dimensionnement des composants et son ´
integration au syst ´ | eme global. `

### 2.1 Convertisseur Buck-Boost

Le cœur fonctionnel de la carte est constitue par le convertisseur DC-DC en topolo- ´
gie buck-boost, implement ´ | e avec le contr ´ | oleur synchrone LT8390. Comme illustr ˆ | e´ a la `
Figure 1, le LT8390 integre un contr ` | oleur ˆ | a quatre interrupteurs (MOSFETs Q2, Q3, Q4 `
et Q5 sur la Figure 2) autour d’un unique inducteur (L1), autorisant le fonctionnement en mode buck, boost ou buck-boost sans circuits externes supplementaires pour la gestion ´ des transitions de mode. Le dimensionnement de tous les composants (filtres, induc-
teurs, condensateurs de decouplage et r ´ | esistances de d ´ | etection de courant) s’appuie ´
sur les calculs et recommandations du datasheet du LT8390, garantissant que le circuit respecte les exigences de performance et de fiabilite du fabricant. ´

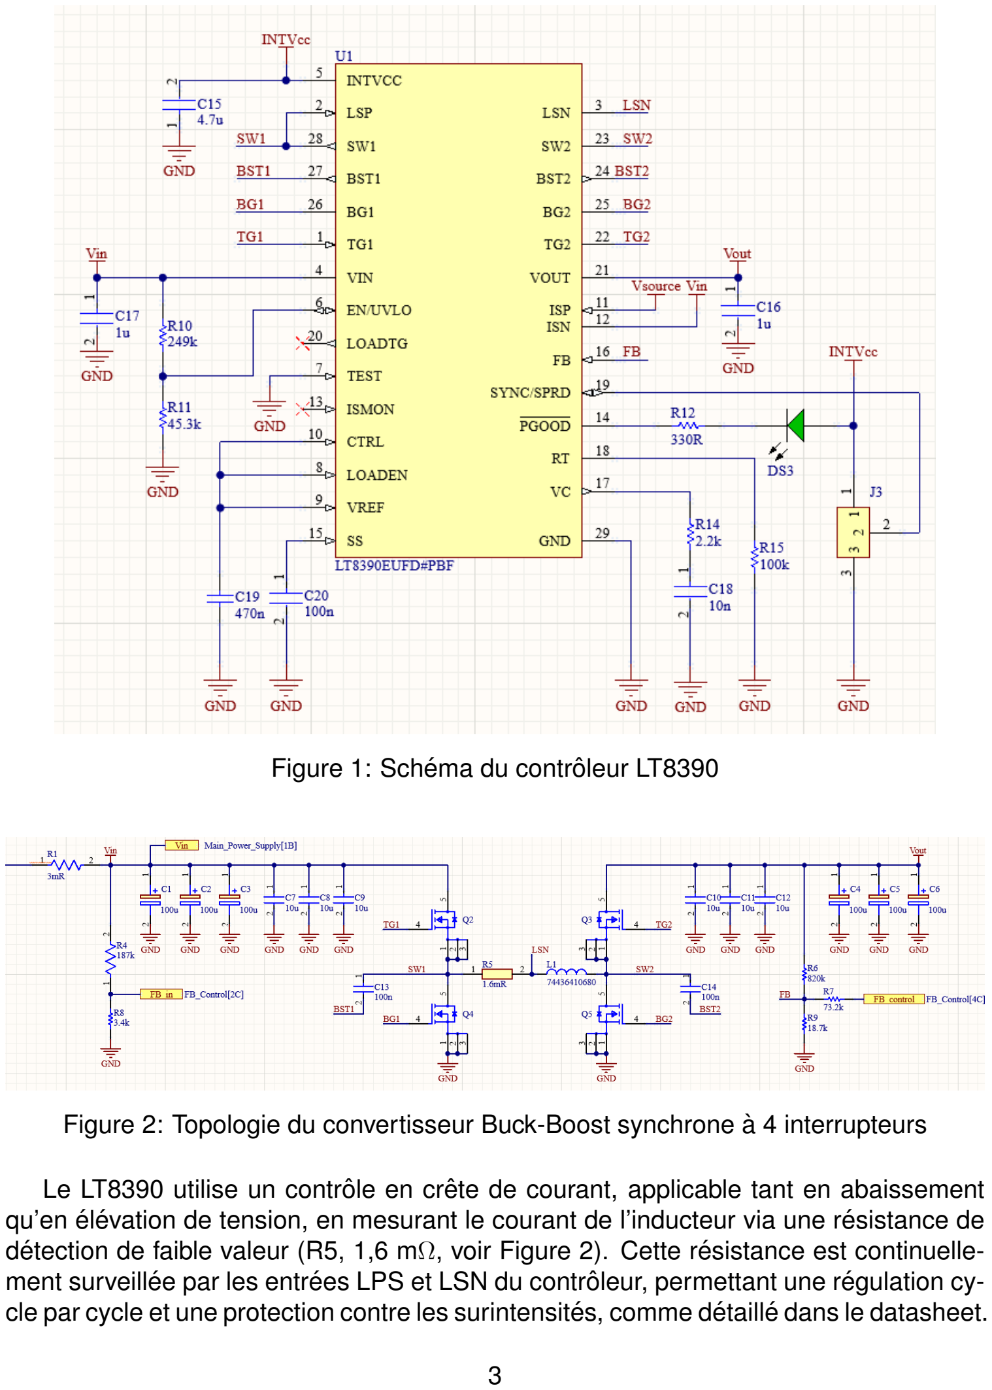
[picture p25: page 4]

Figure 1: Schema du contr ´ | oleur LT8390 ˆ

Figure 2: Topologie du convertisseur Buck-Boost synchrone a 4 interrupteurs `

Le LT8390 utilise un controle en cr ˆ | ete de courant, applicable tant en abaissement ˆ
qu’en el ´ evation de tension, en mesurant le courant de l’inducteur via une r ´ | | | esistance de ´
detection de faible valeur (R5, 1,6 m ´ | | Ω, voir Figure 2). Cette resistance est continuelle- ´
ment surveillee par les entr ´ | ees LPS et LSN du contr ´ | oleur, permettant une r ˆ | egulation cy- ´
cle par cycle et une protection contre les surintensites, comme d ´ | etaill ´ | e dans le datasheet. ´

La precision du contr ´ | ole de courant, associ ˆ | ee´ a la commutation synchrone ` | a haute `
frequence (400 kHz, r ´ | egl ´ ee par la r ´ | esistance R15), offre des rendements sup ´ | erieurs ´
a 95% sur la majeure partie de la plage de fonctionnement, et pouvant atteindre 98% `
selon l’exemple de ref ´ erence du fabricant. Dans ce projet, l’efficacit ´ | e maximale simul ´ | ee´
en conditions optimales a et ´ e de 93%, satisfaisante pour une application aux limites de ´
tension et de courant specifi ´ | ees par le LT8390. ´
Pour attenuer les bruits et interf ´ | erences ´ | electromagn ´ | etiques susceptibles d’induire ´
des signaux parasites sur les pistes voisines, de destabiliser la boucle de r ´ | egulation ´
ou d’emettre vers d’autres ´ | equipements sensibles, le LT8390 int ´ | egre une modulation `
de frequence ´ | a spectre ` | etal ´ | e (spread-spectrum). Plut ´ | ot que de toujours commuter ˆ | a`
une frequence fixe, dont les composantes spectrales concentr ´ | ees risqueraient de vio- ´
ler les normes EMI ou de brouiller des circuits RF voisins, cette modulation fait fluctuer
leg´ erement la fr ` | equence de commutation dans le temps, r ´ | epartissant l’ ´ | energie sur une ´
bande plus large et reduisant ainsi les pics de densit ´ | e spectrale. L’activation de cette ´
fonction s’effectue via le jumper J3 (broche SYNC/SPRD) sur la Figure 1. Dans les appli-
cations ou de faibles pics de bruit peuvent nuire ` | a des circuits analogiques ou des mod- `
ules RF (tel ´ ecommunications, instruments de mesure sensibles), le spread-spectrum ´ est particulierement avantageux. `
Le controleur offre en outre un soft-start (broche SS), une protection UVLO (Under ˆ Voltage Lockout) en cas de sous-tension d’entree, ainsi qu’une protection interne contre ´
les courts-circuits et surcharges, avec possibilite de red ´ | emarrage automatique ou de ´
latch-off, selon le manuel technique du LT8390.
Lors de la phase de conception, un reseau de d ´ | ecouplage et de filtrage a ´ | et´ e mis ´
en place, comportant plusieurs condensateurs en entree et en sortie, essentiel pour ´ limiter le bruit, amortir les transitoires et stabiliser la boucle de regulation. Les valeurs ´
d’inductance et de capacite ont ´ | et ´ e calcul ´ | ees d’apr ´ | es les formules de ripple de courant `
et de tension du datasheet, garantissant que le courant de crete reste en dessous des ˆ limites du fabricant et que la tension de sortie demeure stable meme lors de variations ˆ rapides de charge. Le ripple tensionnel pico-pico maximal projete´ etait de 900 mV pp, ´
d’ou l’emploi de condensateurs d’entr ` | ee (C1, C2, C3, C7, C8, C9) et de sortie (C4, ´
C5, C6, C10, C11, C12) de 10 µF et 100 µF a faible ESR, comme recommand ` | e par le ´
LT8390.
En fonctionnement, le convertisseur accepte une tension d’alimentation de 8 V a` 56 V en entree (broche VIN du LT8390) et se met en veille si la tension descend en ´
dessous de 8 V (grace ˆ | a l’UVLO interne). Le courant d’entr ` | ee maximal projet ´ | e est de ´
30 A, dimensionne par la r ´ | esistance de d ´ | etection et les MOSFETs, pour r ´ | epondre ´ | a`
des charges lourdes. En mode buck-boost, la tension de sortie est reglable entre 0 ´
V et 56 V, tandis qu’en mode buck strict, la sortie varie de 0 V a la tension d’entr ` | ee´
(Vin). La selection du mode s’effectue via un interrupteur d ´ | edi ´ e sur le PCB, mais c’est ´
le LT8390 qui, selon la ref ´ erence de tension pr ´ | esente sur la broche FB (aliment ´ | ee par ´
la commande externe, detaill ´ | ee ult ´ | erieurement), pilote la commutation des MOSFETs ´
pour atteindre la tension desir ´ | ee. Les r ´ | esistances de r ´ | etroaction R6, R7 et R9 (Figure ´

2) definissent le rapport entre la tension de sortie et le signal de feedback, assurant une ´ operation stable sur l’ensemble de la plage 0-56 V. ´

### 2.2 Protection contre l’inversion de polarite´

La protection contre l’inversion de polarite sur cette carte est r ´ | ealis ´ | ee´ a l’aide d’un `
circuit a base de MOSFET, qui bloque tout courant si la source d’alimentation est con- `
nectee´ a l’envers, tout en maintenant des pertes tr ` | es faibles. Cette configuration emp ` | eche ˆ
la tension de sortie d’etre invers ˆ | ee et prot ´ | ege ` | a la fois le convertisseur et les autres blocs `
de la carte en cas d’inversion accidentelle des cables sur les connecteurs d’entr ˆ | ee. ´
Comme illustre´ a la Figure 3, la tension d’entr ` | ee (Vsource) arrive sur le drain du ´
MOSFET Q1 (dont le diode de corps interne est oriente pour bloquer les courants in- ´ verses) et, lorsque la source est correctement connectee, circule vers le reste du circuit ´
avec une chute de tension negligeable gr ´ | ace ˆ | a la faible valeur de ` | RDSponq
. La gate de
Q1 est ref ´ erenc ´ | ee au drain via un pont diviseur et un diode Zener (D1), qui limite la ´
tension VGS pour ne pas depasser la limite s ´ | ure du MOSFET. Dans cette condition de ˆ
polarite correcte, la tension appliqu ´ | ee´ a la gate reste l ` | eg´ erement n ` | egative par rapport ´
a la source (selon le mod ` | ele de MOSFET), forc¸ant Q1 ` | a rester parfaitement satur ` | e. Si- ´
multanement, la LED verte (DS2) s’allume, indiquant ´ | ! alimentation correcte ", car son
anode est relie´ a Vsource et son cathode au point COM. `


Figure 3: Circuit de protection contre l’inversion de polarite´

En cas d’inversion de polarite, la source n ´ | egative se retrouve sur le drain de Q1, ´
mais le diode de corps interne bloque tout passage de courant dans ce sens. De plus,

la tension d’entree invers ´ | ee rend le nœud de gate plus positif que la source, ce qui fait ´
depasser ´ | VGS du seuil de conduction et force Q1 a s’ ` | eteindre compl ´ | etement. Le diode `
Zener D1 garantit que cette surtension sur la gate ne det´ eriore pas le transistor, tandis ´
que la resistance ´ | R3 (en serie avec D1) limite le courant traversant le Zener, maintenant ´
VGS a un niveau s ` | ur. Dans cette situation, la LED rouge (DS1) s’allume, car elle ne ˆ
conduit que lorsque l’entree est invers ´ | ee, signalant ´ | ! polarite incorrecte ´ | ".
En resum ´ | e, le point cl ´ | e de ce sch ´ | ema est la topologie ´ | ! MOSFET inverse´ " : le corps
de Q1 sert de diode de blocage en cas d’inversion, la gate est maintenue a une tension ` qui l’empeche de conduire, et la combinaison d’un pont diviseur et d’un diode Zener ˆ garantit qu’au reconnecter la source correctement, la gate est tiree l ´ eg´ erement sous la ` source, autorisant une conduction normale avec une chute de tension minimale. En d’autres termes, en connexion correcte, le MOSFET conduit sans pertes significatives ,
en connexion inversee, il reste ferm ´ | e, prot ´ | egeant le convertisseur et les circuits en aval. ´
Les LEDs offrent une indication visuelle immediate de l’ ´ | etat de la connexion. ´
Ainsi, le circuit de protection contre l’inversion de polarite utilise un unique MOS- ´
FET a diode de corps interne, une r ` | esistance de gate et un diode Zener pour limiter ´
VGS. Grace ˆ | a cette combinaison, le sch ` | ema assure une protection instantan ´ | ee en cas ´
d’inversion des cables, pr ˆ | esente des pertes de conduction quasi nulles en configuration ´
correcte et indique visuellement le statut de la connexion via des LEDs dedi ´ ees. ´

### 2.3 Sources d’Alimentation Internes de 5V (Convertisseur Fly-Buck)

La carte necessite plusieurs sources d’alimentation basse tension pour ses com- ´
posants de commande, ses tensions de ref´ erence et ses circuits int ´ | egr ´ es (CI), couvrant ´
a la fois la partie isol ` | ee et la partie non isol ´ | ee du syst ´ | eme. Pour r ` | epondre ´ | a ce besoin, `
qui consiste a convertir la haute tension d’entr ` | ee principale du circuit (comprise entre 8 ´
V et 56 V, comme specifi ´ | e par le projet) en niveaux de 5 V, un convertisseur DC/DC en ´
topologie Fly-Buck a et ´ e impl ´ | ement ´ | e. Ce choix est strat ´ | egique, car il permet de g ´ | en´ erer ´
des sorties isolees, ce qui est id ´ | eal pour alimenter des circuits ne devant pas ´ | etre en ˆ
contact direct avec le bus principal, comme le circuit de signal de commande isole. Le ´ cœur de cette solution est le controleur LM5160A de Texas Instruments, un CI robuste ˆ et efficace conc¸u a cet effet. `
Comme illustre´ a la Figure 4, ce circuit constitue la source principale alimentant `
tous les circuits isoles et non isol ´ | es de la carte. Il utilise une topologie d ´ | evelopp ´ | ee par ´
Texas Instruments qui combine les caracteristiques d’un convertisseur Buck, capable ´ d’abaisser une tension d’entree pour en obtenir une autre, et d’un convertisseur Fly- ´
back, ou une tension de sortie isol ` | ee est g ´ | en´ er´ ee´ a partir de l’entr ` | ee. Cet agencement ´
est employe pour r ´ | eduire la tension d’entr ´ | ee, qui peut atteindre 56 V, en deux sources ´
d’alimentation basse tension : une non isolee, destin ´ | ee´ a alimenter tous les composants `
(CI, amplificateurs operationnels, g ´ | en´ eration de signaux de r ´ | ef´ erence), et une isol ´ | ee, ´
dedi ´ ee´ a l’alimentation du circuit de signal de commande isol ` | e. Cette topologie con- ´
stitue une solution tres efficace, capable de fournir toutes les sources n ` | ecessaires pour ´

l’ensemble des sous-systemes de la PCB. De plus, elle offre une haute efficacit ` | e et une ´
faible dissipation de puissance, minimisant l’impact sur l’efficacite globale du convertis- ´ seur Buck-Boost principal.

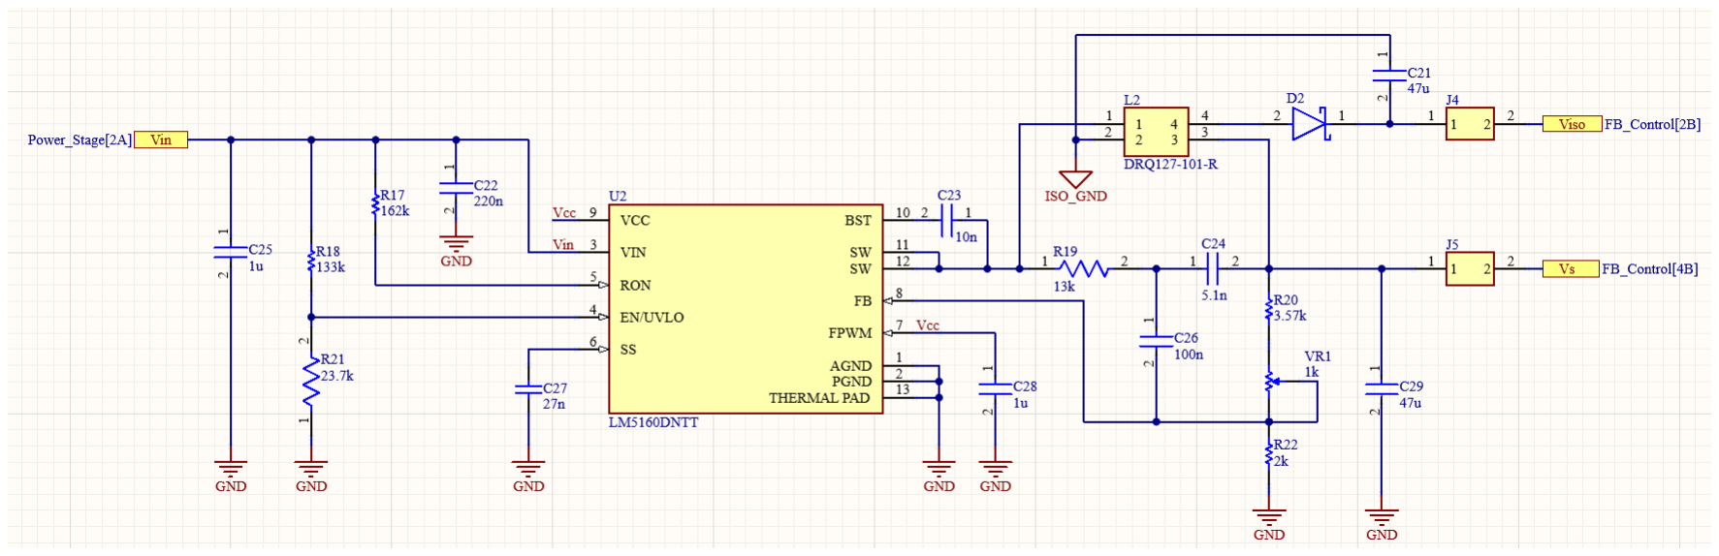
[picture p26: figure]

Figure 4: Schema du Convertisseur Fly-Buck ´

Le circuit d’alimentation interne de 5 V est centre sur le contr ´ | oleur LM5160A de ˆ
Texas Instruments (U2 dans le schema), un convertisseur abaisseur synchrone (step- ´
down) 65 V/2 A qui se distingue par l’integration de MOSFETs haute et basse lat ´ | eral. ´
Cette integration supprime le besoin de diodes Schottky externes pour la rectification, ´
contribuant directement a l’efficacit ` | e en r ´ | eduisant les pertes de conduction et simplifiant ´
la nomenclature (BOM) ainsi que le routage de la carte. Le LM5160A fonctionne selon
un schema de contr ´ | ole en temps de conduction constant adaptatif (COT), qui dispense ˆ
de toute compensation de boucle externe, simplifiant le design et offrant une reponse ´
transitoire rapide. La frequence de commutation, r ´ | eglable par un simple r ´ | esistor, peut ´
atteindre 1 MHz et reste pratiquement constante.
La capacite du LM5160A ´ | a op ` | erer en mode PWM forc ´ | e (FPWM) est essentielle pour ´
son usage en topologie Fly-Buck a sorties multiples, garantissant un transfert d’ ` | energie ´
regulier vers les sorties isol ´ | ees m ´ | eme en cas de faible charge. Le CI int ˆ | egre ` | egalement ´
des protections robustes, telles que la limitation de courant de pic, la protection UVLO
(Under Voltage Lockout) et le declenchement thermique, renforc¸ant la fiabilit ´ | e. La na- ´
ture synchrone du LM5160A, utilisant des MOSFETs plutot que des diodes en basse ˆ
lateral, est cruciale pour l’op ´ | eration Fly-Buck, car une diode bloquerait le courant in- ´
verse n ´ ecessaire pour transf ´ | erer l’ ´ | energie vers la sortie isol ´ | ee. ´
La topologie Fly-Buck est une variante du convertisseur Buck synchrone, ou l’inducteur `
traditionnel est remplace par un inducteur coupl ´ | e (L2 dans le sch ´ | ema) poss ´ | edant plusieurs ´
enroulements. Cette modification permet au circuit non seulement de gen´ erer une sortie ´ non isolee, comme un Buck conventionnel (Vs), mais aussi de produire une ou plusieurs ´
sorties isolees (Viso), de mani ´ | ere analogue ` | a un Flyback. `
La sortie non isolee est g ´ | en´ er´ ee c ´ | otˆ e primaire de l’inducteur coupl ´ | e et est directe- ´
ment regul ´ | ee par la boucle ferm ´ | ee du LM5160A. Sa tension est d ´ | etermin ´ | ee par le rap- ´
port cyclique D et la tension d’entree´ Vin, selon la relation Vout1 D -Vin. Cette sortie
alimente les composants de commande gen´ eraux sur la partie non isol ´ | ee de la carte, ´

le reseau de r ´ | etroaction ´ | etant compos ´ | e de R19, R20, VR1 et R22. La sortie isol ´ | ee´
provient d’un enroulement secondaire de l’inducteur couple. La tension de cette sortie ´
est regul ´ | ee par ´ | ! cross-regulation " via le couplage des enroulements, selon l’expression
approximative Vout2 Vout1 -

pN2{N1q Vf , ou` N1 et N2 sont les nombres de spires et Vf la chute de tension du diode secondaire (D2). Cette sortie est indispensable pour les circuits requerant un isolement galvanique. ´
En termes resum ´ | es, l’op ´ | eration du convertisseur Fly-Buck se divise en deux phases ´
principales, control ˆ ees par la commutation des MOSFETs internes du LM5160A. En ´
mode Ton (High-Side active), la tension d’entr ´ | ee s’applique ´ | a l’enroulement primaire de `
l’inducteur couple, emmagasinant de l’ ´ | energie, tandis que le diode D2 en sortie isol ´ | ee´
est bloque et le condensateur C21 alimente la charge isol ´ | ee. En mode ´ | Toff (Low-Side
active, High-Side d ´ | esactiv ´ | e), la tension du primaire devient n ´ | egative, polarisant D2 en ´
direct et transferant l’ ´ | energie stock ´ | ee vers la sortie isol ´ | ee. Le fonctionnement en FPWM ´
garantit que le MOSFET basse lateral reste conducteur, autorisant le courant invers ´ | e´
necessaire au transfert d’ ´ | energie. ´
En somme, le circuit d’alimentation interne de 5 V, base sur la topologie Fly-Buck et ´
le controleur LM5160A, constitue une solution tr ˆ | es efficace et robuste pour les besoins `
energ ´ | etiques de la carte. Sa capacit ´ | e´ a g ` en´ erer simultan ´ | ement des sorties isol ´ | ees et ´
non isolees ´ | a partir d’une seule entr ` | ee haute tension, associ ´ | ee´ a une conception sim- `
plifiee (sans optocoupleurs), une efficacit ´ | e´ elev ´ | ee et d’excellentes performances EMC, ´
le rend ideal pour des applications industrielles exigeantes. Cet agencement assure ´ non seulement une alimentation stable et fiable de tous les sous-systemes, mais con- `
tribue egalement ´ | a l’efficacit ` | e globale et ´ | a la protection des circuits en aval, garantissant `
l’integrit ´ | e et le bon fonctionnement du syst ´ | eme. `

### 2.4 Circuit de Signal de Commande Externe Isole´

Le circuit isole de la carte est charg ´ | e de recevoir un signal de commande externe, ´
qui peut etre soit au format tension (0 V ˆ | a 5 V), soit au format courant (4 mA ` | a 20 mA), et `
de le preparer pour le circuit principal du convertisseur Buck-Boost. Une caract ´ | eristique ´
essentielle de ce circuit est l’isolation galvanique complete par rapport au reste de la `
carte, garantissant l’integrit ´ | e et la s ´ | ecurit ´ | e du syst ´ | eme principal face aux bruits et tran- `
sitoires de la source externe. Pour cela, le circuit integre un s ` | electeur d’entr ´ | ee et un ´
amplificateur isole analogique de haute lin ´ | earit ´ | e, centr ´ | e sur l’optocoupleur HCNR200. ´
Comme illustre´ a la Figure 5, le circuit se divise en deux zones distinctes : la zone isol ` | ee´
(a gauche de la ligne pointill ` | ee rouge) et la zone non isol ´ | ee ( ´ | a droite), la transition ` | etant ´
assuree par le HCNR200 pour garantir l’isolation requise. ´

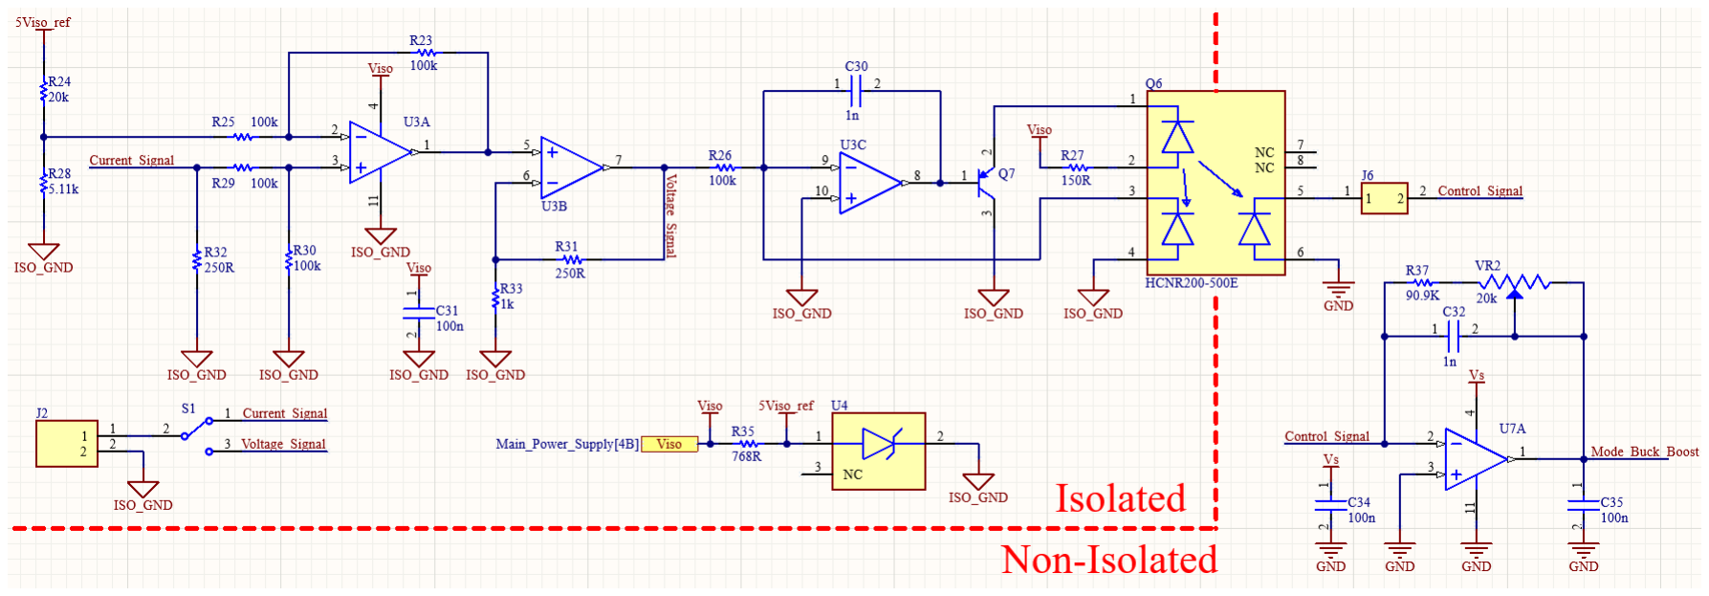
[picture p27: figure]

Figure 5: Circuit de signal de commande externe isole´

Le circuit offre a l’utilisateur la flexibilit ` | e de choisir le type de signal de commande, ´
tension ou courant, via l’interrupteur S1. En mode tension, le signal d’entree analogique ´
(Voltage Signal) est directement dirige vers le circuit d’isolation et transf ´ | er´ e de la zone ´
isolee vers la zone non isol ´ | ee. En mode courant, le signal d’entr ´ | ee (Current ´ | Signal) subit
d’abord un conditionnement avant isolation. Cette etape est cruciale pour convertir le ´ courant en une tension 0 V-5 V compatible avec le traitement suivant.
Lorsque S1 est en mode courant, le signal Current Signal passe par trois etapes de ´
conversion : d’abord, une resistance de shunt de 250 ´ | Ω transforme le courant 4-20 mA
en une tension de 1 V-5 V , ensuite, un amplificateur operationnel (U3A), configur ´ | e en ´
soustracteur, retire l’offset de 1 V du signal. Pour cela, une tension de ref´ erence de ´
1 V est gen´ er´ ee´ a partir de la r ` | ef ´ erence 5Viso ´ | ref produite par U4, au moyen du pont
diviseur R24/R28. Cette 1 V est soustraite de la plage 1-5 V, donnant 0 V-4 V. Enfin,
un second amplificateur operationnel (U3B), avec un gain de 1,25, ´ | etend la plage 0 V-4 ´
V a 0 V-5 V. Le signal standardis ` | e 0-5 V est alors achemin ´ | e vers l’amplificateur isol ´ | e´
analogique.
L’isolation galvanique, point central du circuit, est realis ´ | ee par l’optocoupleur ´ | a haute `
linearit ´ | e HCNR200-500E (Q6). Ce composant robuste permet d’isoler les signaux ana- ´
logiques tout en offrant stabilite, lin ´ | earit ´ | e et bande passante ´ | elev ´ | ees. Le HCNR200 ´
comprend une LED haute performance qui eclaire deux photodiodes appari ´ | ees (PD1 et ´
PD2). Le processus d’isolation et de linearisation fonctionne ainsi : le signal de tension ´ (Voltage Signal), issu du mode tension ou du conditionnement en mode courant, est
applique´ a l’amplificateur U3C. Cet amplificateur, assist ` | e par le transistor Q7, contr ´ | oleˆ
le courant du LED interne du HCNR200 (broches 1-2). Une photodiode (PD1, broches
3-4) est utilisee en boucle de r ´ | etroaction avec U3C. En surveillant la lumi ´ | ere ` | emise et en ´
ajustant le courant, les non-linearit ´ | es et d ´ | erives du LED sont quasiment annul ´ | ees, assur- ´
ant une relation lineaire entre le signal d’entr ´ | ee et l’intensit ´ | e lumineuse, quel que soit la ´
temperature ou l’ ´ | age du LED. La seconde photodiode (PD2, broches 5-6), optiquement ˆ
couplee, g ´ | en´ ere une photocourant lin ` | eairement proportionnelle ´ | a l’intensit ` | e lumineuse. ´
Cette photocourant est ensuite reconvertie en tension sur le cotˆ e non isol ´ | e, produisant ´
le signal de commande final (Control Signal) pour le convertisseur Buck-Boost. Le parfait appariement des photodiodes et le design du boˆıtier garantissent la haute linearit ´ e´ et la stabilite du gain. Le HCNR200 offre une isolation de 5000 Vrms, essentielle pour ´
les applications necessitant une s ´ | ecurit ´ | e´ elev ´ | ee et une protection contre les transitoires ´
mode commun et les boucles de masse.
2.5 Circuit de Controle et S ˆ | election de Mode ´

Ce circuit final est le maillon crucial entre le signal de commande externe isole et ´
le controleur principal du convertisseur Buck-Boost, le LT8390. Sa fonction premi ˆ | ere `
est de recevoir le signal de commande dej ´ a isol ` | e, de g ´ | erer la s ´ | election entre les modes ´
d’operation Buck et Buck-Boost, puis d’inverser le signal de commande avant de l’envoyer ´
a la broche de r ` | etroaction (FB) du LT8390. ´
Traditionnellement, la boucle de retroaction d’un convertisseur DC/DC est compos ´ | ee´
d’un diviseur resistif qui ´ | echantillonne la tension de sortie et la compare ´ | a une r ` | ef´ erence ´
interne du controleur, ce qui d ˆ | efinit une tension de sortie fixe. Cependant, pour des ap- ´
plications requerant une tension de sortie variable et ajustable dynamiquement, comme ´
dans ce projet, une approche plus sophistiquee est n ´ | ecessaire. La technique, large- ´
ment utilisee dans les modules de puissance, consiste ´ | a injecter ou drainer un faible `
courant dans le reseau de r ´ | etroaction du r ´ | egulateur. Cette injection modifie le gain ef- ´
fectif du diviseur, agissant comme une ! | resistance virtuelle ´ | " | qui deplace le point de ´
reglage du convertisseur. Plus pr ´ | ecis ´ | ement, si un courant positif est inject ´ | e au nœud de ´
retroaction, la tension de sortie baisse. Inversement, si un courant est pr ´ | elev ´ | e (c’est- ´ | a-`
dire un courant negatif inject ´ | e), la tension de sortie augmente. Cette m ´ | ethode offre un ´
controle plus pr ˆ | ecis et flexible compar ´ | e´ a la simple commutation de r ` | esistances. Pour ´
implementer cette fonctionnalit ´ | e, une troisi ´ | eme r ` | esistance est raccord ´ | ee au nœud cen- ´
tral du diviseur de retroaction du LT8390, permettant l’injection du signal de commande ´
externe en ce point. Le circuit illustre´ a la Figure 6 g ` | en´ ere ce signal de commande, qui `
est injecte sur la broche FB du LT8390 via cette troisi ´ | eme r ` | esistance, comme montr ´ | e´ a`
la Figure 2.

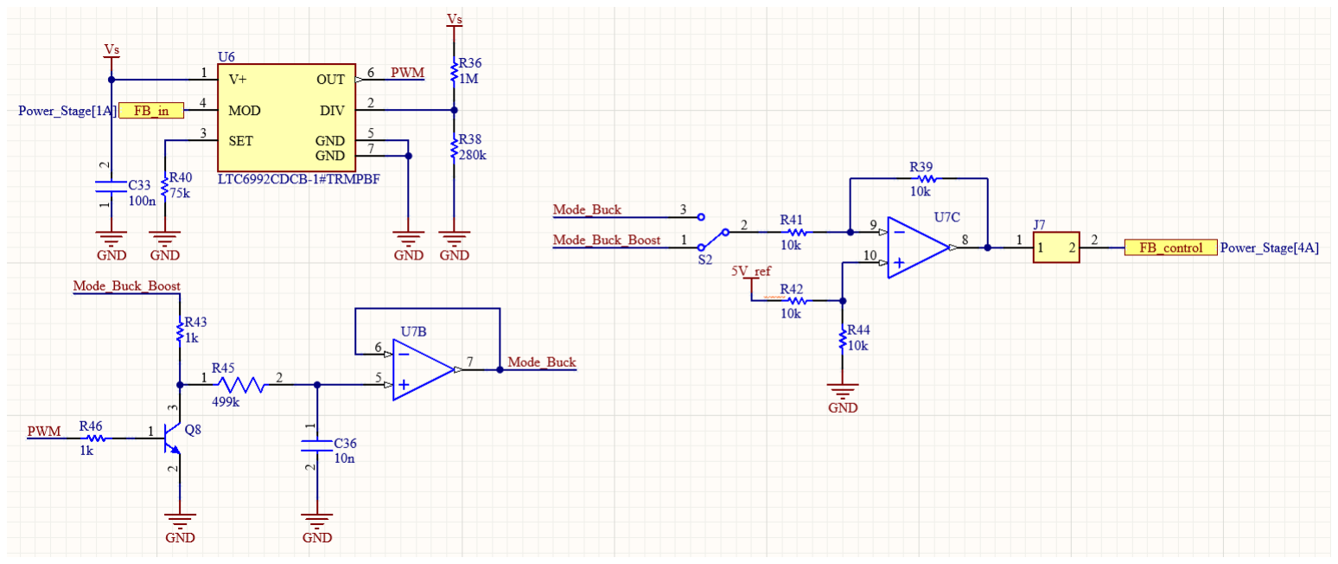
[picture p28: figure]

Figure 6: Circuit de Controle et S ˆ | election de Mode ´
Le circuit integre un s ` | electeur de mode S2 permettant ´ | a l’utilisateur de choisir entre `
deux operations distinctes : le mode Buck-Boost et le mode Buck. En mode Buck-Boost, ´ l’objectif est que la tension de sortie du convertisseur principal varie de 0 V a 56 V en `
reponse ´ | a un signal de commande externe variant de 0 V ` | a 5 V (ou 4 mA ` | a 20 mA `
apres conditionnement). Par exemple, un signal de commande de 0 V doit donner 0 V ` en sortie, tandis que 5 V en signal de commande doit conduire a 56 V en sortie. Pour ` obtenir cette relation, le signal de commande externe est d’abord inverse de 0-5 V en 5-0 ´
V grace ˆ | a l’amplificateur op ` | erationnel U7C configur ´ | e en soustracteur. L’une des entr ´ | ees ´
du soustracteur rec¸oit le signal de commande et l’autre une tension de ref´ erence de 5 ´ V : lorsqu’il y a 0 V en commande, la sortie du soustracteur est 5 V (5 V - 0 V = 5 V), et lorsqu’il y a 5 V en commande, la sortie est 0 V (5 V - 5 V = 0 V).
La logique derriere cette inversion est que, pour l’injection de courant dans la boucle `
FB du LT8390, une tension d’injection plus elev ´ | ee en FB entra ´ | ˆıne une tension de sortie
plus faible. Ainsi, un signal externe de 0 V (devenu 5 V apres inversion) ` | ! | tire " | la FB
vers le bas, diminuant la sortie a 0 V , inversement, un signal externe de 5 V (devenu `
0 V apres inversion) autorise la mont ` | ee de la tension de sortie jusqu’ ´ | a 56 V, ` | etablissant ´
la relation inverse necessaire. Ce signal invers ´ | e est ensuite connect ´ | e´ a la troisi ` | eme `
resistance de la boucle FB du LT8390. ´
En mode Buck-Boost, la tension de sortie varie de 0-56 V en fonction du signal
externe 0-5 V (ou 4-20 mA apres conditionnement). Par exemple, 0 V commande 0 V ` | a`
la sortie, 2,5 V commande 28 V, 5 V commande 56 V. Pour fonctionner dans ce mode,
le signal issu du circuit de commande isole est dirig ´ | e vers l’entr ´ | ee de S2, puis passe ´
par le circuit inverseur decrit pr ´ | ec´ edemment avant d’ ´ | etre inject ˆ | e en FB via la r ´ | esistance ´
virtuelle.
En mode Buck, la tension de sortie doit varier de 0 V jusqu’a la tension d’entr ` | ee (Vin), ´
et non jusqu’a 56 V. Par exemple, pour Vin = 24 V, 0 V commande 0 V ` | a la sortie sortie, `
5 V commande 24 V sortie. Pour adapter le LT8390, configure pour 56 V en Buck-Boost, ´
a cette nouvelle plage, un circuit de contr ` | ole transforme le signal externe en une tension ˆ

de retroaction ´ | equivalente ´ | a Vin. Cela se fait en modulant le signal externe par un PWM `
dont le rapport cyclique depend de Vin. L’oscillateur LTC6992 (U6) g ´ | en´ ere ce PWM : sa `
broche MOD rec¸oit une tension FB in proportionnelle a Vin, modulant le duty-cycle. La ` sortie PWM commande Q8, puis un filtre passe-bas RC (R45, C36) convertit le PWM en tension analogique moyenne. Ce signal est enfin bufferise par U7B, garantissant ´
l’integrit ´ | e et l’isolation d’imp ´ | edance, puis envoy ´ | e´ a l’autre entr ` | ee de S2. Quel que soit ´
le mode, le signal final est ensuite inverse par U7C avant d’ ´ | etre reli ˆ | e´ a la broche FB du `
LT8390.
En somme, ce circuit est essentiel a la polyvalence et au contr ` | ole pr ˆ | ecis de la carte. ´
Il permet non seulement la selection flexible entre les modes Buck et Buck-Boost, mais ´
aussi le conditionnement et l’inversion appropries du signal isol ´ | e pour interagir efficace- ´
ment avec la boucle FB modifiee du LT8390. La combinaison de la modulation PWM ´
pilotee par Vin et de l’injection de courant contr ´ | ol ˆ ee dans FB offre un ajustement lin ´ | eaire ´
et previsible de la tension de sortie, optimisant les performances du convertisseur prin- ´ cipal dans diverses conditions d’exploitation.

## 3 Conception de la PCB dans Altium

Le projet de la carte de circuit imprime (PCB) a ´ | et´ e enti ´ | erement r ` | ealis ´ | e dans l’envi- ´
ronnement Altium Designer, en respectant des criteres techniques de performance, de `
fiabilite et, surtout, de co ´ | ut de fabrication. Avec des dimensions finales de 100 mm sur ˆ
60 mm, la PCB a et ´ e conc¸ue pour ´ | etre aussi compacte que possible, r ˆ | epondant aux ´
exigences electriques du syst ´ | eme sans compromettre son organisation physique. Cette `
taille reduite, en plus de faciliter l’int ´ | egration dans des bo ´ | ˆıtiers plus petits, reduit signi- ´
ficativement les couts de production, notamment gr ˆ | ace ˆ | a l’utilisation d’un simple empile- `
ment deux couches (Top et Bottom) plutot qu’ ˆ | a un layout multicouche plus co ` | uteux et ˆ
complexe.
Le routage a et ´ e planifi ´ | e selon les bonnes pratiques pour convertisseurs DC/DC ´
recommandees dans le datasheet du LT8390. Des directives sp ´ | ecifiques ont ´ | et´ e suiv- ´
ies pour le placement des MOSFETs de puissance, des condensateurs d’entree et de ´
sortie, des resistances de d ´ | etection de courant et des autres ´ | el ´ ements critiques. Les ´
MOSFETs ont et ´ e positionn ´ | es au plus pr ´ | es de l’inducteur principal, minimisant ainsi la `
surface de la boucle de courant HF. Les condensateurs d’entree sont group ´ | es et plac ´ | es´
a proximit ` | e de la broche VIN du LT8390 et de l’entr ´ | ee du circuit, garantissant une faible ´
inductance de piste et une reponse rapide aux transitoires. De m ´ | eme, les conden- ˆ
sateurs de sortie sont situes pr ´ | es du nœud VOUT, assurant une faible imp ` | edance de ´
sortie a haute fr ` | equence. Toutes les r ´ | esistances de mesure, comme R5, sont c ´ | abl ˆ ees ´
en Kelvin pres des broches LSP/LSN du contr ` | oleur afin de pr ˆ | eserver la pr ´ | ecision de la ´
mesure de courant et d’eviter les perturbations dans la boucle de r ´ | egulation. ´
La couche Top regroupe tous les composants actifs et passifs, incluant les el ´ ements ´ de puissance, de commande et de traitement du signal. Les pistes de forte intensite sont ´
dimensionnees en polygones larges pour supporter jusqu’ ´ | a 30 A de courant d’entr ` | ee´

sans pertes excessives. La couche Bottom sert principalement de plan de masse con-
tinu, offrant une faible impedance de retour pour les signaux et am ´ | eliorant la dissipation ´
thermique. Les interconnexions entre Top et Bottom sont renforcees par de multiples ´
vias, favorisant la dissipation de chaleur et maintenant l’integrit ´ | e´ electrique. ´
Chaque sous-circuit est dispose en zones bien d ´ | elimit ´ | ees et compactes sur la carte, ´
avec un espacement adapte entre les blocs de puissance, de commande et de signal, ce ´ qui facilite l’identification visuelle et la mise au point materielle lors des tests. Les circuits ´
sont organises pour ´ | eviter les interf ´ | erences entre signaux sensibles et pistes de com- ´
mutation haute frequence, en s ´ | eparant soigneusement les plans de masse analogique ´
et de puissance. La PCB comporte egalement une zone galvanique isol ´ | ee, situ ´ | ee dans ´
le coin oppose aux connecteurs d’entr ´ | ee et de sortie de tension, d ´ | elimit ´ | ee visuellement ´
par un polygone de lignes blanches en serigraphie. Cette zone abrite les circuits de ´
signal de commande isole, garantissant la s ´ | ecurit ´ | e et l’immunit ´ | e aux bruits provenant ´
de l’entree externe. Toutes les pistes traversant cette fronti ´ | | | ere passent exclusivement `
par l’optocoupleur HCNR200, assurant l’isolation electrique totale entre les parties du ´ systeme. `
La realisation de la PCB utilise majoritairement des composants CMS (Component ´ Mount Surface), ce qui permet un layout plus compact et reduit les inductances para- ´ sites sur les pistes de signal. Quelques composants THT (Through-Hole) sont toutefois presents, tels que les connecteurs, les jumpers de configuration, les interrupteurs et cer- ´
tains condensateurs, tous places de mani ´ | ere accessible pour faciliter l’usage de sondes `
lors des tests en banc. L’emploi de la technologie CMS contribue egalement ´ | a r ` eduire ´
les couts d’assemblage et ˆ | a optimiser l’utilisation de l’espace disponible sur la carte. `
Pour simplifier la verification et la caract ´ | erisation du syst ´ | eme, des jumpers et con- `
necteurs dedi ´ es ont ´ | et ´ e ajout ´ | es, permettant d’activer ou de d ´ | esactiver des blocs sp ´ | eci- ´
fiques de la carte sans intervention materielle directe. Ces jumpers permettent, par ex- ´ emple, de mettre temporairement hors service le convertisseur Fly-Buck, le circuit de protection contre l’inversion de polarite ou l’isolation de signal, facilitant ainsi les tests ´ individuels de chaque sous-systeme. `
Les Figures 7, 8 et 9 ci-apres illustrent respectivement la vue de la couche sup ` | erieure ´
de la carte, la couche inferieure avec le plan de masse et la vue 3D compl ´ | ete de la PCB, `
mettant en evidence le positionnement des blocs principaux et l’organisation g ´ | | | | en´ erale ´
du projet, tandis que la Figure 10 montre la carte reelle assembl ´ | ee, soulignant la qualit ´ | e´
de fabrication et la disposition des composants.

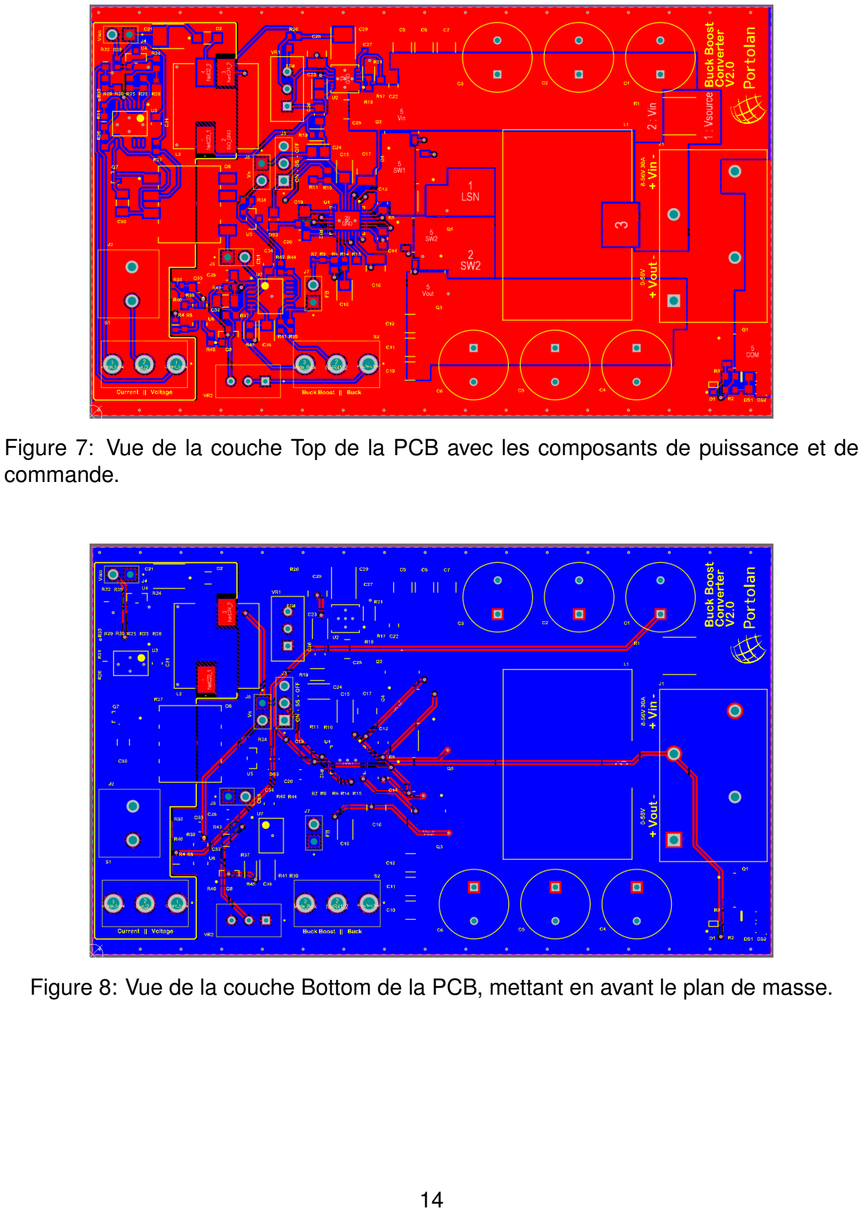
[picture p29: page 15]

Figure 7: Vue de la couche Top de la PCB avec les composants de puissance et de commande.

Figure 8: Vue de la couche Bottom de la PCB, mettant en avant le plan de masse.

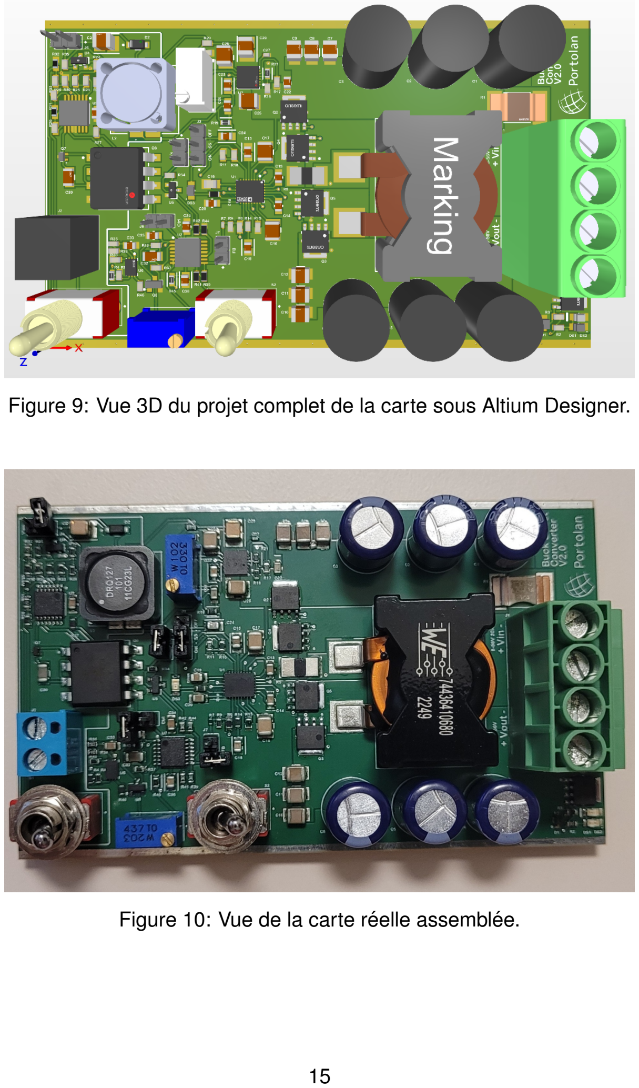
[picture p30: page 16]

Figure 9: Vue 3D du projet complet de la carte sous Altium Designer.

Figure 10: Vue de la carte reelle assembl ´ | ee. ´

## 4 Etape de Tests ´

Cette section decrit la proc ´ | edure de tests effectu ´ | es sur la carte d ´ | evelopp ´ | ee, d ´ | etaillant ´
chaque phase de verification, les ´ | equipements utilis ´ | es et les r ´ | esultats observ ´ | es lors ´
de l’analyse fonctionnelle des sous-circuits. L’objectif etait de garantir le bon fonction- ´ nement de chaque module individuellement, ainsi que d’evaluer les performances glob- ´
ales de la carte en conditions reelles d’utilisation, d’identifier d’ ´ | eventuelles d ´ | efaillances ´
et de valider le comportement des blocs critiques du systeme. `
Pour la realisation des tests, les ´ | equipements de laboratoire suivants ont ´ | et´ e em- ´
ployes : un multim ´ | etre num ` | erique pour les mesures de tension, de courant et de con- ´
tinuite , une pince amp ´ | erem ` | etrique pour l’analyse de la consommation en temps r ´ | eel , ´
une alimentation variable jusqu’a 56 V pour alimenter le circuit principal , une alimenta- ` tion secondaire de 5 V pour les tests isoles , un oscilloscope pour l’analyse des signaux ´ de commande, des commutations et des bruits , ainsi que des jumpers et cables de ˆ connexion.
Le processus de tests a debut ´ | e par une inspection visuelle minutieuse de la carte ´
montee, afin de v ´ | erifier d’ ´ | eventuelles erreurs de fabrication ou d’assemblage. Les di- ´
mensions de la PCB (100 mm x 60 mm), la presence de tous les composants pr ´ | evus, ´
leur positionnement correct, la polarite des dispositifs sensibles (condensateurs ´ | electro- ´
lytiques, diodes) et la coherence entre le sch ´ | ema Altium et la disposition physique ont ´
et ´ e v ´ erifi ´ | es. Le circuit a ´ | egalement ´ | et´ e compar ´ | e au plan original de conception pour ´
s’assurer qu’aucun ecart structurel n’avait ´ | et´ e introduit. ´
Une fois cette etape termin ´ | ee, les mesures initiales ont ´ | et´ e effectu ´ | ees, notamment ´
des tests de continuite entre les bornes d’alimentation (Vin et GND) et entre l’entr ´ | ee et ´
la sortie des blocs principaux. L’objectif etait de d ´ | etecter d’ ´ | eventuels courts-circuits ou ´
defauts de soudure compromettant l’alimentation. La continuit ´ | e des LED a aussi ´ | et´ e´
verifi ´ | ee pour contr ´ | oler le bon fonctionnement des indicateurs visuels, tant en polarit ˆ | e´
directe qu’inverse.
Avant les tests fonctionnels complets, tous les jumpers d’interconnexion entre les
modules ont et ´ e retir ´ | es, permettant de tester chaque bloc de mani ´ | ere isol ` | ee et contr ´ | ol ˆ ee. ´
L’analyse fonctionnelle a commence par le convertisseur Fly-Buck g ´ | en´ erant les sources ´
internes de 5 V. Ce circuit s’est comporte comme pr ´ | evu, fournissant des tensions sta- ´
bles aux circuits isoles et non isol ´ | es. La tension a ´ | et´ e ajust ´ | ee via le potentiom ´ | etre de `
calibration et est restee dans la plage sp ´ | ecifi ´ | ee, m ´ | eme en charge variable. ˆ
Le circuit de protection contre l’inversion de polarite a ´ | egalement parfaitement fonc- ´
tionne. En polarit ´ | e correcte, il laissait passer la tension vers le reste de la carte et al- ´
lumait la LED verte, indiquant !polarite correcte ´ | ". Lors d’une inversion volontaire, il blo-
quait le courant et allumait la LED rouge, signalant la condition d’erreur, conformement ´ au design theorique. ´
Cependant, tous les modules n’ont pas et´ e exempts d’anomalies. Dans la zone ´
isolee, le circuit de conditionnement et d’amplification du signal de commande a pr ´ | esent ´ | e´
de l’instabilite lors de tests prolong ´ | es. Un ´ | echauffement anormal d’un des amplificateurs ´

operationnels a ´ | et ´ e observ ´ | e, probablement d ´ | uˆ a un transitoire ou ` | a une mauvaise ma- `
nipulation durant les tests. Bien que le composant n’ait pas grille, le circuit suivant de ´
selection de mode en a ´ | et ´ e impact ´ | e, ses entr ´ | ees d ´ | ependant directement de l’ ´ | etage ´
prec´ edent. En cons ´ | equence, les signaux inject ´ | es dans la boucle de r ´ | etroaction du ´
LT8390 ne correspondaient pas aux valeurs attendues, compromettant le controle de ˆ la tension de sortie.
Concernant le convertisseur principal Buck-Boost base sur le LT8390, toutes les ´
tensions d’entree´ etaient pr ´ | esentes : l’alimentation 8 V-56 V, le signal EN/UVLO, le soft- ´
start (SS) et la ref ´ erence de feedback. Pourtant, aucune tension significative n’a ´ | et´ e´
gen´ er´ ee en sortie, et la consommation restait faible et constante, sans ´ | echauffement du ´
controleur, indiquant qu’il n’ ˆ | etait ni endommag ´ | e ni en court-circuit. ´
Une explication possible de ce comportement inattendu est l’interference ´ | electro- ´
magnetique g ´ | en´ er´ ee par la commutation haute fr ´ | equence des MOSFETs et le cou- ´
plage parasite dans les nœuds sensibles du circuit de commande. Cette EMI peut perturber la boucle de regulation de courant ou de tension, interrompant la commutation ´
de l’inducteur. Cette hypothese est confirm ` | ee par l’observation d’un bruit susceptible ´
d’affecter directement le FB ou les broches de sensorisation (ISMON, ISP, ISN), in-
hibant les sorties. Une autre possibilite concerne la boucle de feedback elle-m ´ | eme, qui ˆ
pourrait recevoir des signaux deform ´ | es en raison du dysfonctionnement de la s ´ | election ´
de mode, alterant la r ´ | ef ´ erence vue par le LT8390. ´
Pour remedier ´ | a ces probl ` | emes, plusieurs actions correctives sont propos ` | ees: r ´ | eviser ´
le layout PCB pour reduire l’EMI, en s ´ | eparant plus nettement les pistes de puissance ´
et de signal, en utilisant des plans de masse continus et en ajoutant des filtres EMI sur les broches sensibles. Ensuite, effectuer des tests avec blindage partiel ou reduire la ´
frequence de commutation pour confirmer l’origine EMI. Il serait ´ | egalement judicieux de ´
tester la boucle de feedback avec un signal de ref´ erence externe afin de d ´ | eterminer ´
si le probleme vient du contr ` | oleur ou du conditionnement de signaux. Ces actions ˆ
necessitent toutefois des ressources suppl ´ | ementaires, augmentant le co ´ | ut, un facteur ˆ
critique dans cette nouvelle version de la carte.
Enfin, lors de la phase de test en fonctionnement reel, le plan consistait ´ | a alimenter `
la carte avec tous les jumpers en place, a d ` emarrer ´ | a basse tension et courant, puis `
a observer la r ` | eponse du circuit en faisant varier la tension d’entr ´ | ee et le signal de ´
commande. Bien que le convertisseur principal n’ait pas fonctionne comme pr ´ | evu, les ´
tests dynamiques et de puissance des autres circuits ont et´ e men ´ | es avec succ ´ | es. `

## 5 Conclusion

Le developpement de la carte convertisseur Selectable Buck-Boost/Buck Regulator ´
a constitue un projet complexe, couvrant toutes les ´ | etapes de l’ing ´ | enierie ´ | electronique ´
: depuis la definition de l’architecture fonctionnelle, la s ´ | election et le dimensionnement ´
des composants, les simulations detaill ´ | ees et la mod ´ | elisation comportementale via LT- ´
spice, jusqu’a la conception et le routage de la PCB dans Altium Designer, le montage `

pratique et la validation experimentale des circuits. ´
L’utilisation du controleur LT8390, associ ˆ | ee´ a une architecture ` | a quatre interrupteurs `
synchrones et a un contr ` | ole par pic de courant, a fourni une base solide pour la cr ˆ | eation ´
d’un convertisseur DC-DC tres polyvalent, capable de fonctionner efficacement en mode `
Buck comme en mode Buck-Boost. Les resultats pratiques ont confirm ´ | e le bon fonction- ´
nement de blocs tels que la source Fly-Buck 5 V, destinee´ a alimenter les circuits isol ` | es´
et non isoles, ainsi que l’ ´ | etage de protection contre l’inversion de polarit ´ | e, qui s’est com- ´
porte conform ´ | ement aux simulations et aux tests pratiques. ´
La phase de tests a permis de valider une partie des circuits, bien que certaines
limitations soient apparues. Un probleme localis ` | e dans la r ´ | egion isol ´ | ee de commande ´
et d’amplification a partiellement compromis la transmission correcte du signal de commande vers la boucle de retroaction, entravant le fonctionnement attendu du conver- ´
tisseur principal. Malgre cela, les signaux d’entr ´ | ee et les conditions d’op ´ | | | eration du ´
LT8390 etaient appliqu ´ | es correctement, et l’absence de surchauffe ou de consomma- ´
tion anormale suggere que le contr ` | oleur n’a pas ˆ | et´ e endommag ´ | e. L’hypoth ´ | ese principale `
retenue pour l’echec de l’ ´ | etage principal concerne des interf ´ | erences ´ | electromagn ´ | etiques ´
internes ou des defaillances ponctuelles dans la boucle de r ´ | etroaction, qui devraient faire ´
l’objet d’une analyse plus approfondie dans les futures iterations du projet. ´
Malgre les d ´ | efis rencontr ´ | es, le projet a atteint certains de ses objectifs : mettre ´
en œuvre une topologie robuste et compacte de conversion d’energie, employer un ´
controle externe isol ˆ | e pour la r ´ | egulation dynamique de la sortie, et int ´ | egrer tous les ´
sous-systemes sur une seule carte ` | a faible co ` | ut et haute densit ˆ | e. L’approche adopt ´ | ee´
demontre un fort potentiel pour divers projets et applications, tout en n ´ | ecessitant encore ´
des ajustements et des validations supplementaires pour atteindre les performances ´ optimales.
Comme prochaines etapes, il conviendra de proc ´ | eder ´ | a une r ` | e´evaluation d ´ | etaill ´ | ee du ´
layout de la PCB et de l’integrit ´ | e des signaux aux points critiques du circuit, ainsi qu’au ´
remplacement preventif des composants sensibles de l’ ´ | etage isol ´ | e. On s’attend ´ | a ce que `
ces modifications permettent au convertisseur d’atteindre pleinement sa fonctionnalite´
prevue, autorisant des mesures compl ´ | etes de performances et des courbes d’efficacit ` | e.´
