Mateushga1/Buck-Boost-Converter/_deprecated-V1/Linearity_Verification.xlsx

 | Mode Régulateur |  |  | Mode Booster |  |  | V | mA | % | 12V | 24V | 48V
 |  |  |  |  |  |  | 0 | 4 | 0 | 0 | 0 | 0
Commande mA | Vin=12V | Vin=24V | Vin=48V | Vin=12V | Vin=24V | Vin=48V | 0.16 | 4.5 | 3.125 | 0.375 | 0.75 | 1.5
4 | 176,33mV | 175,04mV | 169,66mV |  |  |  | 0.316 | 5 | 6.25 | 0.75 | 1.5 | 3
5 | 906,32mV | 1,6281V | 3,0717V |  |  |  | 0.472 | 5.5 | 9.375 | 1.125 | 2.25 | 4.5
10 | 4,5932V | 9,0398V | 18,016V |  |  |  | 0.628 | 6 | 12.5 | 1.5 | 3 | 6
15 | 8,3393V | 16,53V | 32,916V |  |  |  | 0.784 | 6.5 | 15.625 | 1.875 | 3.75 | 7.5
20 | 12,183V | 24,161V | 45,501V |  |  |  | 0.94 | 7 | 18.75 | 2.25 | 4.5 | 9
 |  |  |  |  |  |  | 1.096 | 7.5 | 21.875 | 2.625 | 5.25 | 10.5
 |  |  |  |  |  |  | 1.252 | 8 | 25 | 3 | 6 | 12
Vo | Vref | Vdac | Rtop | Rbot | Rsub |  | 1.408 | 8.5 | 28.125 | 3.375 | 6.75 | 13.5
45.579 | 1 | 0.926 | 560000 | 12800 | 50000 |  | 1.564 | 9 | 31.25 | 3.75 | 7.5 | 15
 |  |  |  |  |  |  | 1.72 | 9.5 | 34.375 | 4.125 | 8.25 | 16.5
 |  |  |  |  |  |  | 1.876 | 10 | 37.5 | 4.5 | 9 | 18
 |  |  |  |  |  |  | 2.032 | 10.5 | 40.625 | 4.875 | 9.75 | 19.5
 |  |  |  |  |  |  | 2.188 | 11 | 43.75 | 5.25 | 10.5 | 21
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
