Mateushga1/Buck-Boost-Converter/_deprecated-V1/Verification_Linearite.xlsx

Valeurs obtenues |  |  |  |  |  |  | Valeurs attendues
 | Mode Régulateur |  |  | Mode Booster |  |  | Mode Régulateur |  |  |  |  | Mode Booster
Commande mA | Vin=12V | Vin=24V | Vin=48V | Vin=12V | Vin=24V | Vin=48V | mA | % | 12V | 24V | 48V | mA | Vsortie
4 | 176,33mV | 175,04mV | 169,66mV | 31,164mV | 32,154mV | 32,892mV | 4 | 0 | 0 | 0 | 0 | 4 | 0
5 | 906,32mV | 1,6281V | 3,0717V | 3,4384V | 3,4423V | 3,4424V | 4.5 | 3.125 | 0.375 | 0.75 | 1.5 | 4.5 | 1.75
10 | 4,5932V | 9,0398V | 17.935V | 20,927V | 20,919V | 20,941V | 5 | 6.25 | 0.75 | 1.5 | 3 | 5 | 3.5
15 | 8,3393V | 16,53V | 32,929V | 38,415V | 38,427V | 38,437V | 5.5 | 9.375 | 1.125 | 2.25 | 4.5 | 5.5 | 5.25
20 | 12,183V | 24,161V | 48,118V | 55,942V | 55,889V | 55,9V | 6 | 12.5 | 1.5 | 3 | 6 | 6 | 7
 |  |  |  |  |  |  | 6.5 | 15.625 | 1.875 | 3.75 | 7.5 | 6.5 | 8.75
 |  |  |  |  |  |  | 7 | 18.75 | 2.25 | 4.5 | 9 | 7 | 10.5
 |  |  |  |  |  |  | 7.5 | 21.875 | 2.625 | 5.25 | 10.5 | 7.5 | 12.25
 |  |  |  |  |  |  | 8 | 25 | 3 | 6 | 12 | 8 | 14
 |  |  |  |  |  |  | 8.5 | 28.125 | 3.375 | 6.75 | 13.5 | 8.5 | 15.75
 |  |  |  |  |  |  | 9 | 31.25 | 3.75 | 7.5 | 15 | 9 | 17.5
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
