Mateushga1/Buck-Boost-Converter/Simulations/Main_Source/WBDesign13.pdf

## WEBENCH ® Design Report

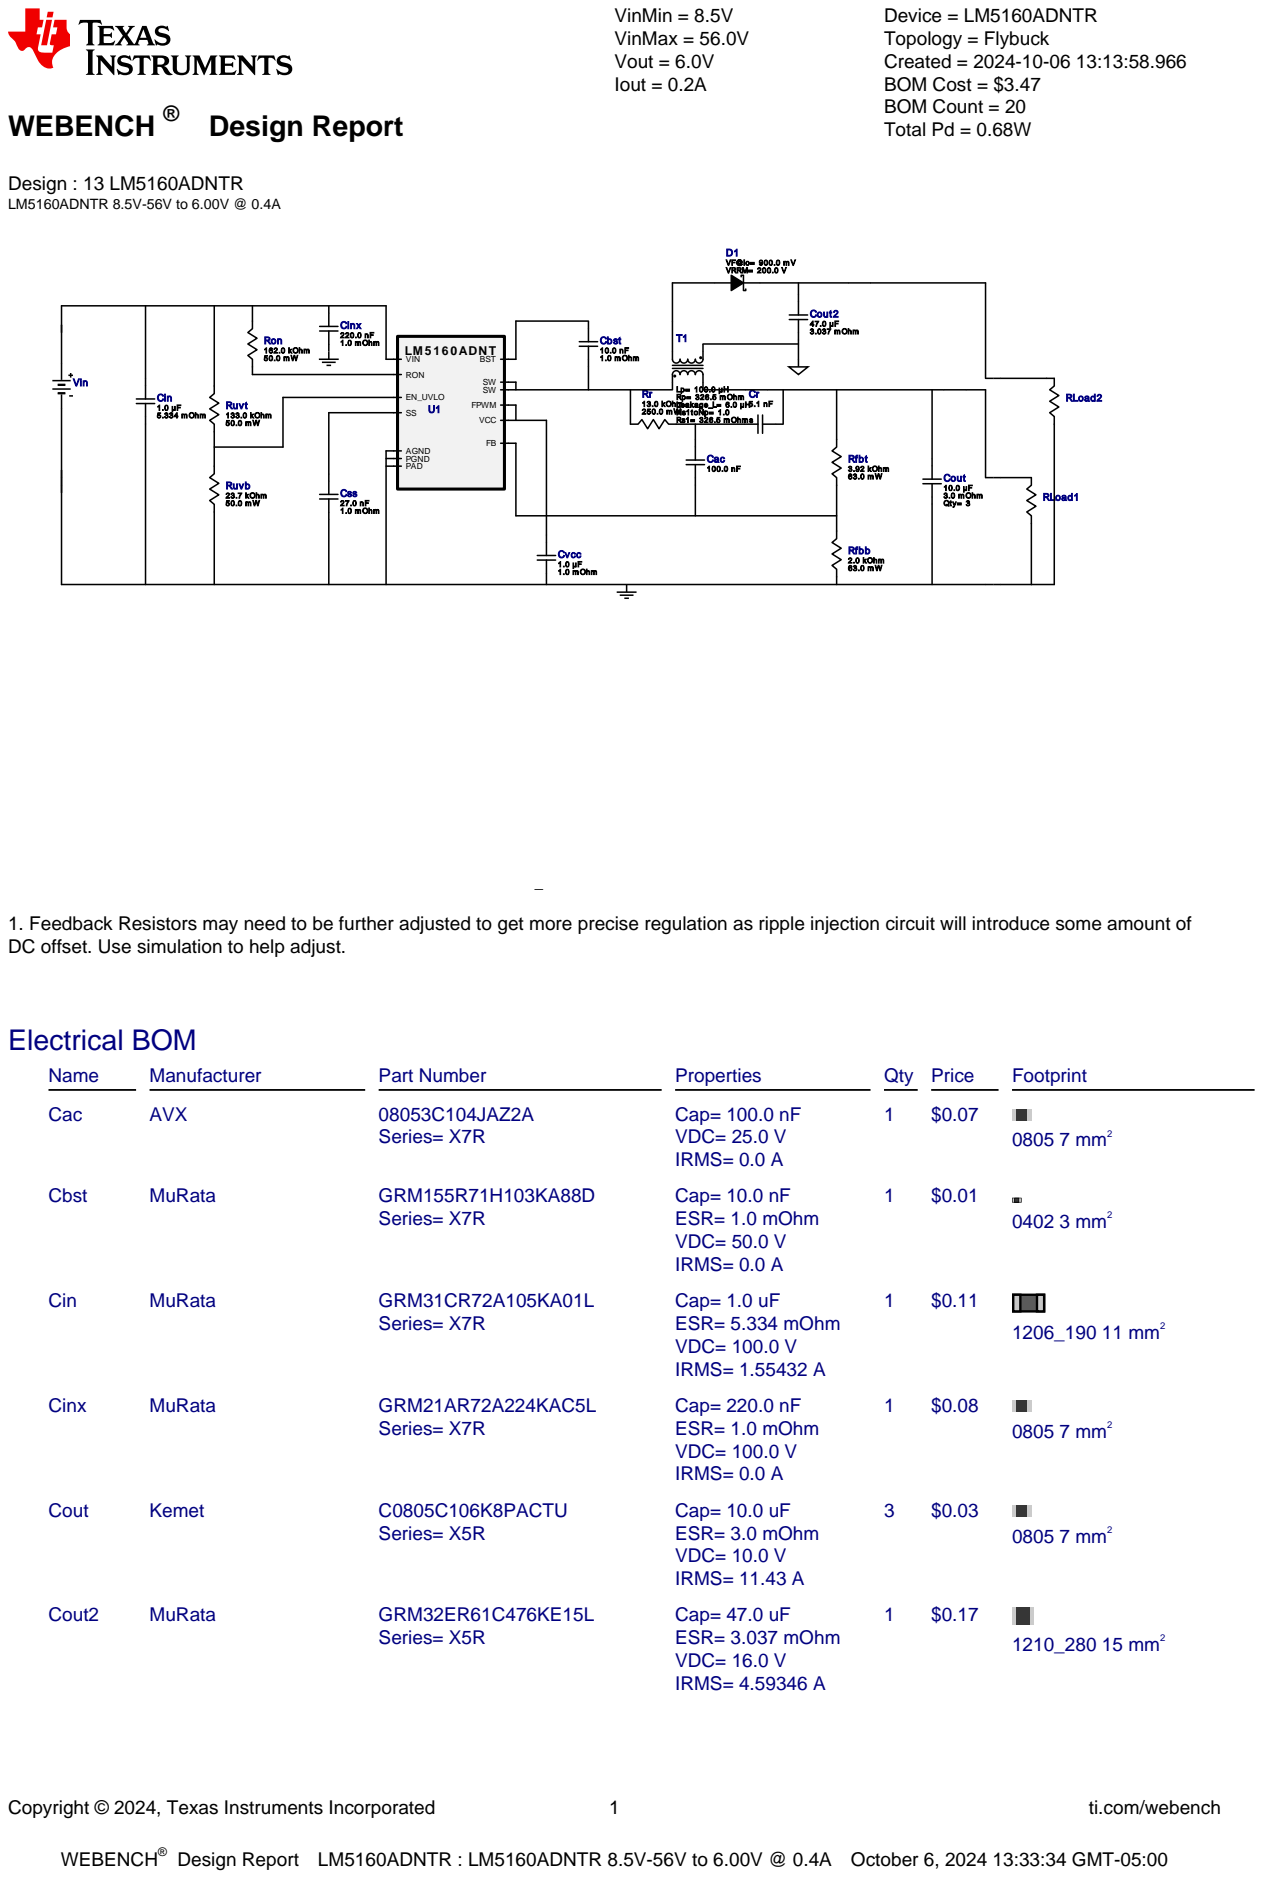
[picture p31: page 1]
Copyright © 2024, Texas Instruments Incorporated; ti.com/webench; WEBENCH®; Design : 13 LM5160ADNTR LM5160ADNTR 8.5V-56V to 6.00V @ 0.4A; VinMin = 8.5V VinMax = 56.0V Vout = 6.0V Iout = 0.2A; Device = LM5160ADNTR Topology = Flybuck Created = 2024-10-06 13:13:58.966 BOM Cost = $3.47 BOM Count = 20 Total Pd = 0.68W; Css 27.0 nF 1.0 m Ohm; Rfbt 3.92 kOhm; Cbst 10.0 nF; 1.0 m Ohm; D1 VF@Io= 900.0 m V VRRM= 200.0 V; Lp= 100.0 µH Rp= 326.5 m Ohm Leakage_L= 6.0 µH Ns1toNp= 1.0 Rs1= 326.5 m Ohm s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

Cr 5.1 nF Rr 13.0 kOhm

1. Feedback Resistors may need to be further adjusted to get more precise regulation as ripple injection circuit will introduce some amount of
DC offset. Use simulation to help adjust.

Design Report LM5160ADNTR : LM5160ADNTR 8.5V-56V to 6.00V @ 0.4A October 6, 2024 13:33:34 GMT-05:00

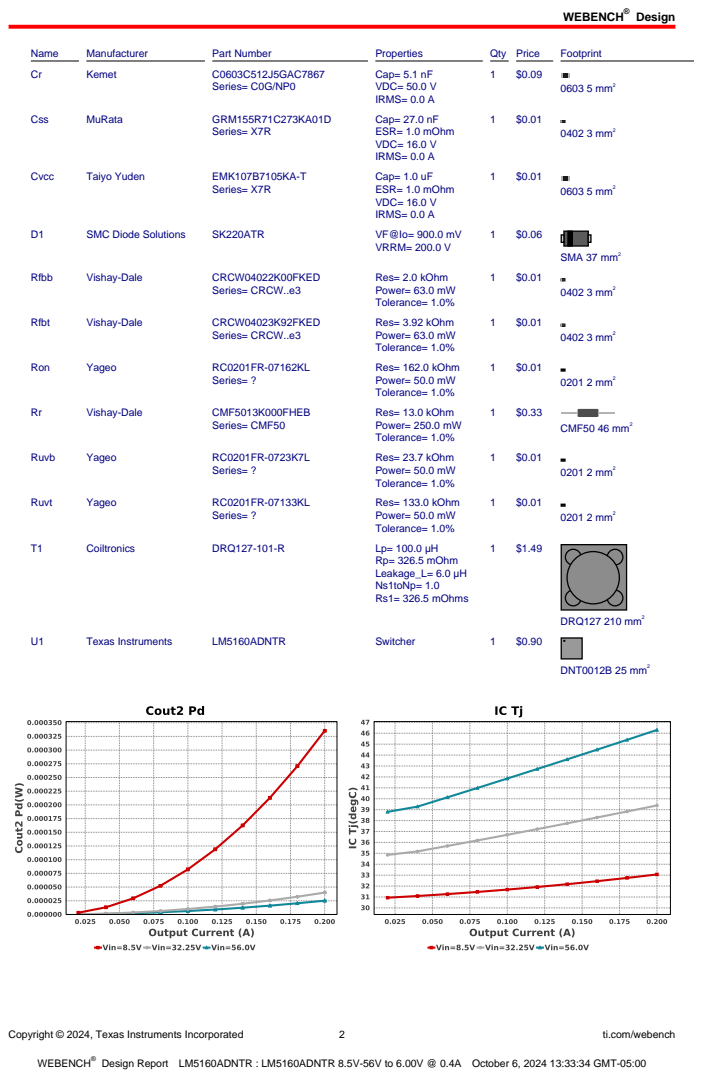
[picture p32: page 2]
Design; Copyright © 2024, Texas Instruments Incorporated; ti.com/webench; Name; Manufacturer; Part Number; Properties; Qty Price; Footprint; Kemet; C0603C512J5GAC7867; Series= C0G/NP0; Cap= 5.1 nF VDC= 50.0 V IRMS= 0.0 A; 0603 5 mm²; Css; MuRata; GRM155R71C273KA01D; Series= X7R; Cap= 27.0 nF ESR= 1.0 mOhm VDC= 16.0 V IRMS= 0.0 A; 0402 3 mm²; Cvcc; Taiyo Yuden; EMK107B7105KA-T; Cap= 1.0 uF ESR= 1.0 mOhm VDC= 16.0 V IRMS= 0.0 A; SMC Diode Solutions; SK220ATR; VRRM= 200.0 V; SMA 37 mm²; Rfbb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

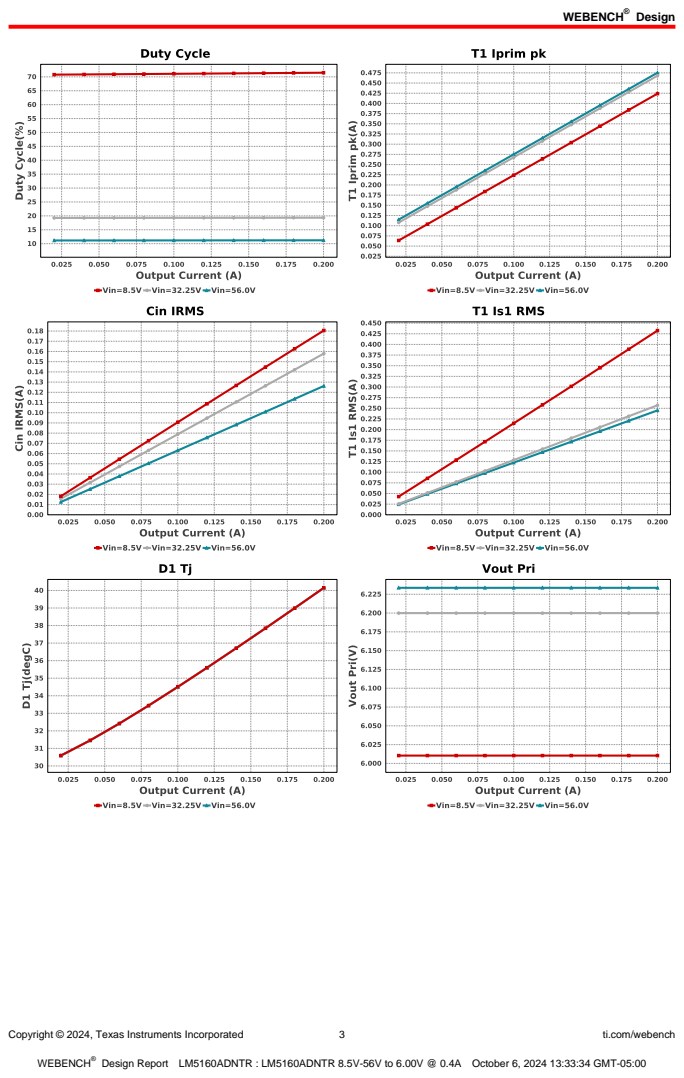
[picture p33: page 3]
Copyright © 2024, Texas Instruments Incorporated; ti.com/webench

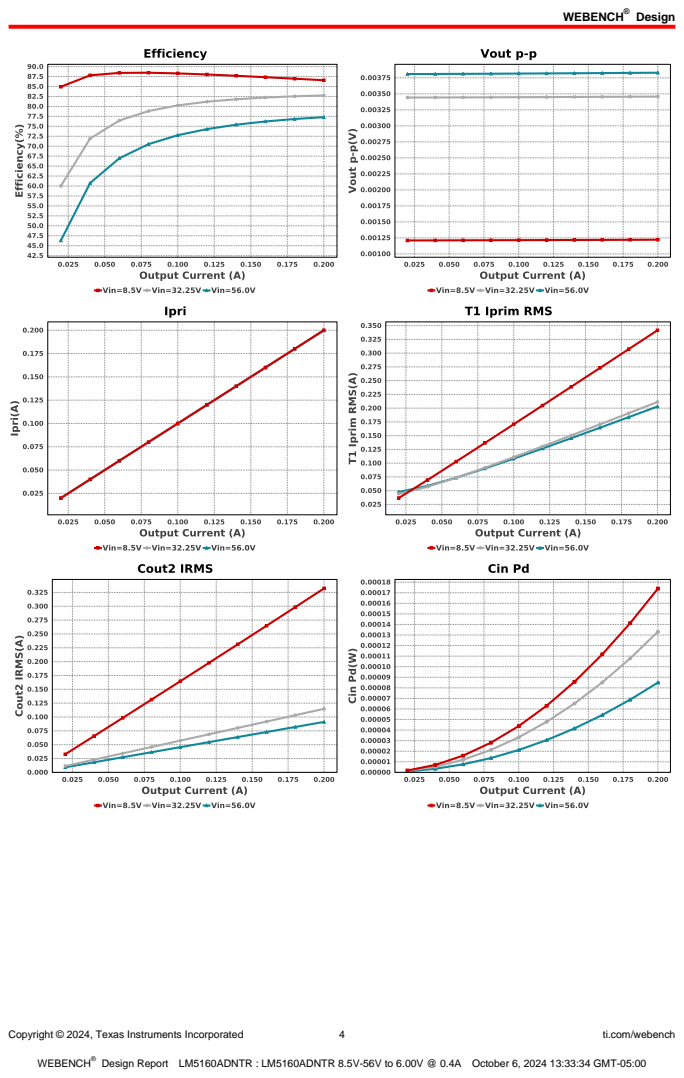
[picture p34: page 4]
Copyright © 2024, Texas Instruments Incorporated; ti.com/webench

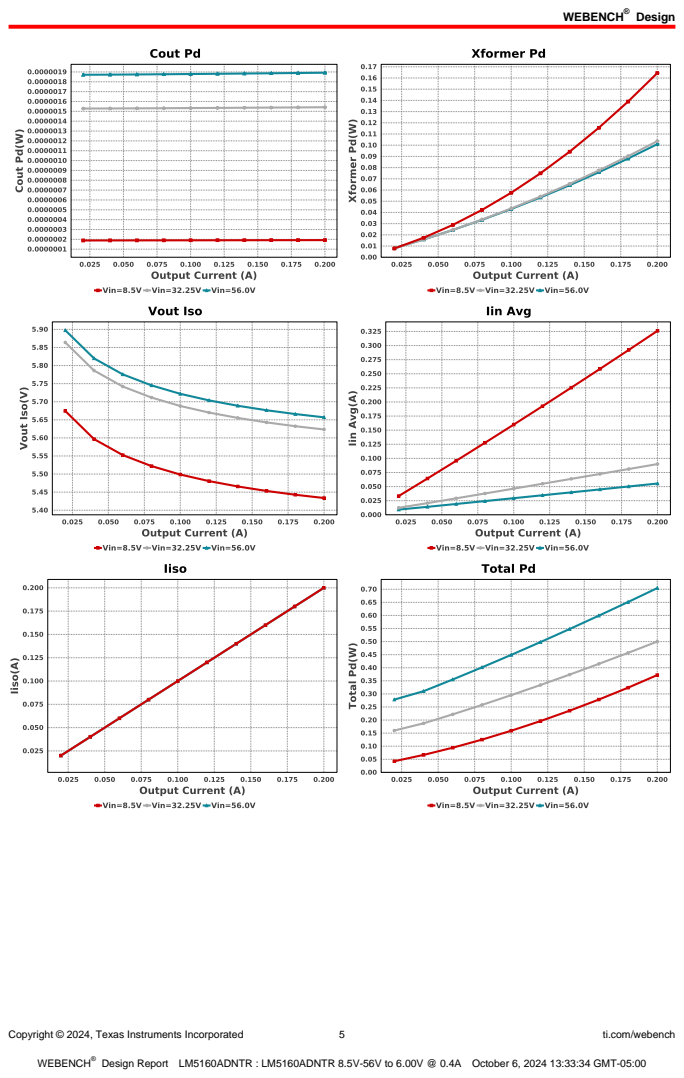
[picture p35: page 5]
Copyright © 2024, Texas Instruments Incorporated; ti.com/webench

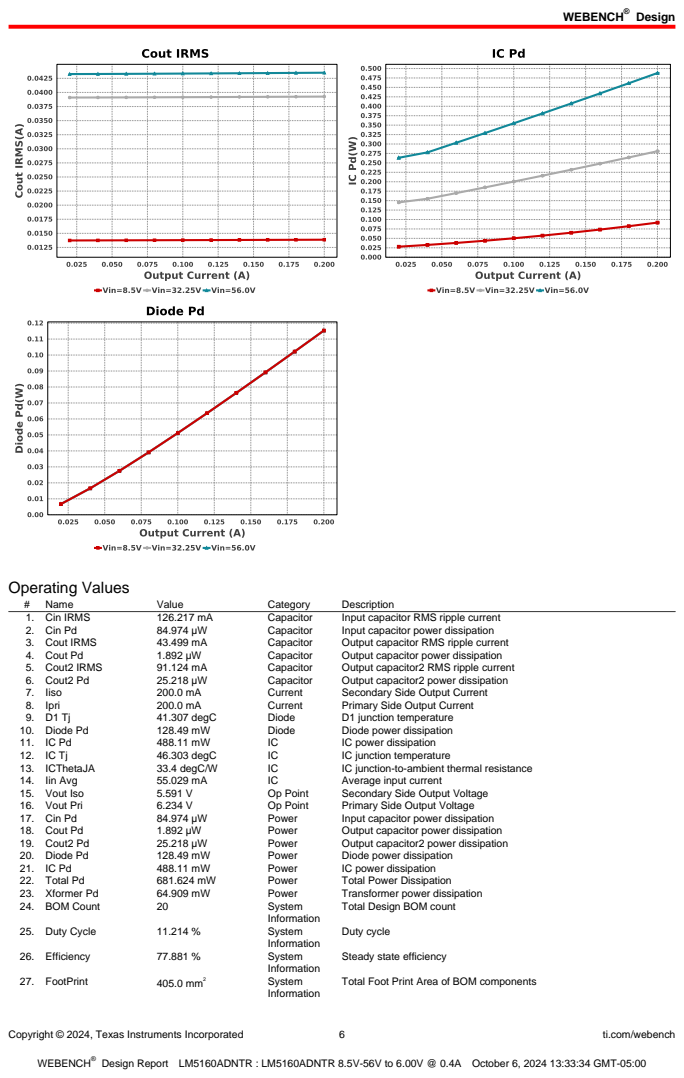
[picture p36: page 6]
Copyright © 2024, Texas Instruments Incorporated; ti.com/webench; Operating Values; Name; Value; Category; Description; 1. Cin IRMS; Capacitor; Input capacitor RMS ripple current; 2. Cin Pd; Input capacitor power dissipation; 3. Cout IRMS; Output capacitor RMS ripple current; 4. Cout Pd; Output capacitor power dissipation; 5. Cout2 IRMS; Output capacitor2 RMS ripple current; 6. Cout2 Pd; Output capacitor2 power dissipation; 7. Iiso; Current; Secondary Side Output Current; 8. Ipri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

Total Design BOM count

Steady state efficiency

Total Foot Print Area of BOM components

Copyright © 2024, Texas Instruments Incorporated | 7 | ti.com/webench
# | Name | Value | Category | Description

28. Frequency | 370.37 kHz | System
| | | Information | Switching frequency
29. Total BOM | $3.47 | System
| | | Information | Total BOM Cost
30. Vin | 56.0 V | System
| | | Information | Vin operating point
31. Vout Actual | 5.92 V | System
| | | Information | Vout Actual calculated based on selected voltage divider resistors
32. Vout Tolerance | 2.604 % | System
| | | Information | Vout Tolerance based on IC Tolerance (no load) and voltage divider
| | | | resistors if applicable
33. Vout p-p | 3.83 mV | System
| | | Information | Peak-to-peak output ripple voltage
34. T1 Iprim RMS | 202.99 mA | Transformer | Transformer Primary RMS Current
35. T1 Iprim pk | 475.343 mA | Transformer | Transformer Primary Peak Current
36. T1 Is1 RMS | 245.091 mA | Transformer | Transformer Secondary1 RMS Current
37. Xformer Pd | 64.909 mW | Transformer | Transformer power dissipation

## Design Inputs

Name | Value | Description
| Iout | | 200.0 m | Maximum Output Current
| Iout1 | | 200.0 m | Output Current #1
| Iout2 | | 200.0 m | Output Current #2
VinMax | 56.0 | Maximum input voltage
VinMin | 8.5 | Minimum input voltage
Vout | 6.0 | Output Voltage
Vout1 | 6.0 | Output Voltage #1
Vout2 | 6.0 | Output Voltage #2
| base_pn | | LM5160A | Base Product Number
source | DC | Input Source Type
Ta | 30.0 | Ambient temperature


Copyright © 2024, Texas Instruments Incorporated | 8 | ti.com/webench

## Assembly

## Component Testing

Some published data on components in datasheets such as Capacitor ESR and Inductor DC resistance is based on conservative values that will guarantee that the components always exceed the specification. For design purposes it is usually better to work with typical values. Since this data is not always available it is a good practice to measure the Capacitance and ESR values of Cin and Cout, and the inductance and DC resistance of L1 before assembly of the board. Any large discrepancies in values should be electrically simulated in WEBENCH to check for instabilities and thermally simulated in WebTHERM to make sure critical temperatures are not exceeded.

## Soldering Component to Board

If board assembly is done in house it is best to tack down one terminal of a component on the board then solder the other terminal. For surface mount parts with large tabs, such as the DPAK, the tab on the back of the package should be pre-tinned with solder, then tacked into place by one of the pins. To solder the tab town to the board place the iron down on the board while resting against the tab, heating both surfaces simultaneously. Apply light pressure to the top of the plastic case until the solder flows around the part and the part is flush with the PCB. If the solder is not flowing around the board you may need a higher wattage iron (generally 25W to 30W is enough).

## Initial Startup of Circuit

It is best to initially power up the board by setting the input supply voltage to the lowest operating input voltage 8.5V and set the input supply's current limit to zero. With the input supply off connect up the input supply to Vin and GND. Connect a digital volt meter and a load if needed to set the minimum Iout of the design from Vout and GND. Turn on the input supply and slowly turn up the current limit on the input supply. If the voltage starts to rise on the input supply continue increasing the input supply current limit while watching the output voltage. If the current increases on the input supply, but the voltage remains near zero, then there may be a short or a component misplaced on the board. Power down the board and visually inspect for solder bridges and recheck the diode and capacitor polarities. Once the power supply circuit is operational then more extensive testing may include full load testing, transient load and line tests to compare with simulation results.

## Load Testing

The setup is the same as the initial startup, except that an additional digital voltmeter is connected between Vin and GND, a load is connected between Vout and GND and a current meter is connected in series between Vout and the load. The load must be able to handle at least rated output power + 50% ( 7.5 watts for this design). Ideally the load is supplied in the form of a variable load test unit. It can also be done in the form of suitably large power resistors. When using an oscilloscope to measure waveforms on the prototype board, the ground leads of the oscilloscope probes should be as short as possible and the area of the loop formed by the ground lead should be kept to a minimum. This will help reduce ground lead inductance and eliminate EMI noise that is not actually present in the circuit.

## Design Assistance

1. For a Constant On Time device to be stable, we need to provide a ripple at the feedback comparator. There are various methods to implement the ripple. Depending on the circuit complexity vs. the allowable ripple, we have three options to choose from. The simplest option, 'Low Complexity', would require only a high ESR cap at the output. This means that the BOM count will be small, but the output voltage ripple will be quite large. The 'Optimal Solution' would require a feed-forward cap in parallel with the upper feedback resistor to AC couple the ripple to the feedback node. This increases the BOM count slightly, but now we have more control over the output voltage ripple. If the output voltage requirement is very tight, then the best option is to go for the 'Low Output Ripple' solution. In this option we can go with very low ESR output caps and have very good control over the output voltage ripple.
2. Master key : E03FC439211E3F9A5803B0C08B508BCF[v1]
3. LM5160A Product Folder : http://www.ti.com/product/LM5160A : contains the data sheet and other resources.

Copyright © 2024, Texas Instruments Incorporated | 9 | ti.com/webench

Important Notice and Disclaimer

TI provides technical and reliability data (including datasheets), design resources (including reference designs), application or other design advice, web tools, safety information, and other resources AS IS and with all faults, and disclaims all warranties. These resources are intended for skilled developers designing with TI products. You are solely responsible for (1) selecting the appropriate TI products for your application, (2) designing, validating and testing your application, and (3) ensuring your application meets applicable standards, and any other safety, security, or other requirements.

These resources are subject to change without notice. TI grants you permission to use these resources only for development of an application that uses the TI products described in the resource. Other reproduction and display of these resources is prohibited. No license is granted to any other TI intellectual property right or to any third party intellectual property right. TI disclaims responsibility for, and you will fully indemnify TI and its representatives against, any claims, damages, costs, losses, and liabilities arising out of your use of these resources.

Providing these resources does not expand or otherwise alter TI's applicable Terms of Sale or other applicable terms available either on ti.com or provided in conjunction with TI products.
