Mateushga1/Buck-Boost-Converter/Simulations/_deprecated/Vsource/WBDesign3.pdf

## WEBENCH ® Design Report

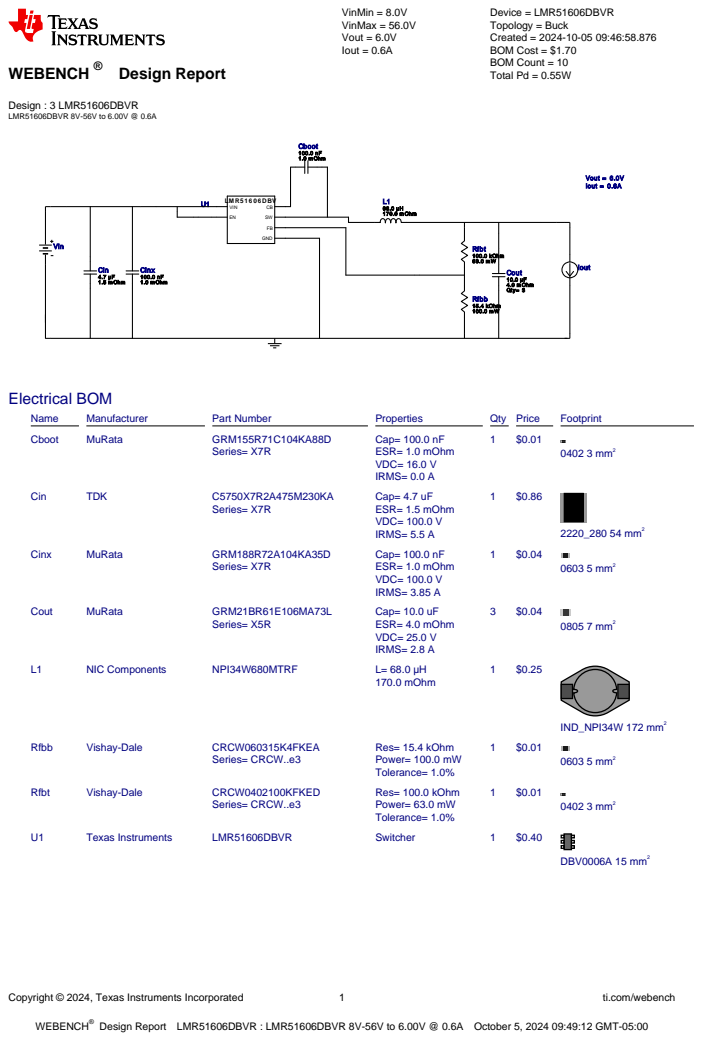
[picture p38: page 1]
Copyright © 2024, Texas Instruments Incorporated; ti.com/webench; WEBENCH®; Design : 3 LMR51606DBVR LMR51606DBVR 8V-56V to 6.00V @ 0.6A; VinMin = 8.0V VinMax = 56.0V Vout = 6.0V Iout = 0.6A; Device = LMR51606DBVR Topology = Buck Created = 2024-10-05 09:46:58.876 BOM Cost = $1.70 BOM Count = 10 Total Pd = 0.55W; L1 68.0 µH 170.0 m Ohm; LM R5 1 6 0 6 DBV CB; GND; VIN; Rfbb 15.4 kOhm 100.0 m W; Rfbt 100.0 kOhm 63.0 m W; Vout = 6.0V Iout = 0.6A; Cboot 100.0 nF 1.0 m Ohm; Cin 4.7 µF 1.5 m Ohm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

Design Report LMR51606DBVR : LMR51606DBVR 8V-56V to 6.00V @ 0.6A October 5, 2024 09:49:12 GMT-05:00

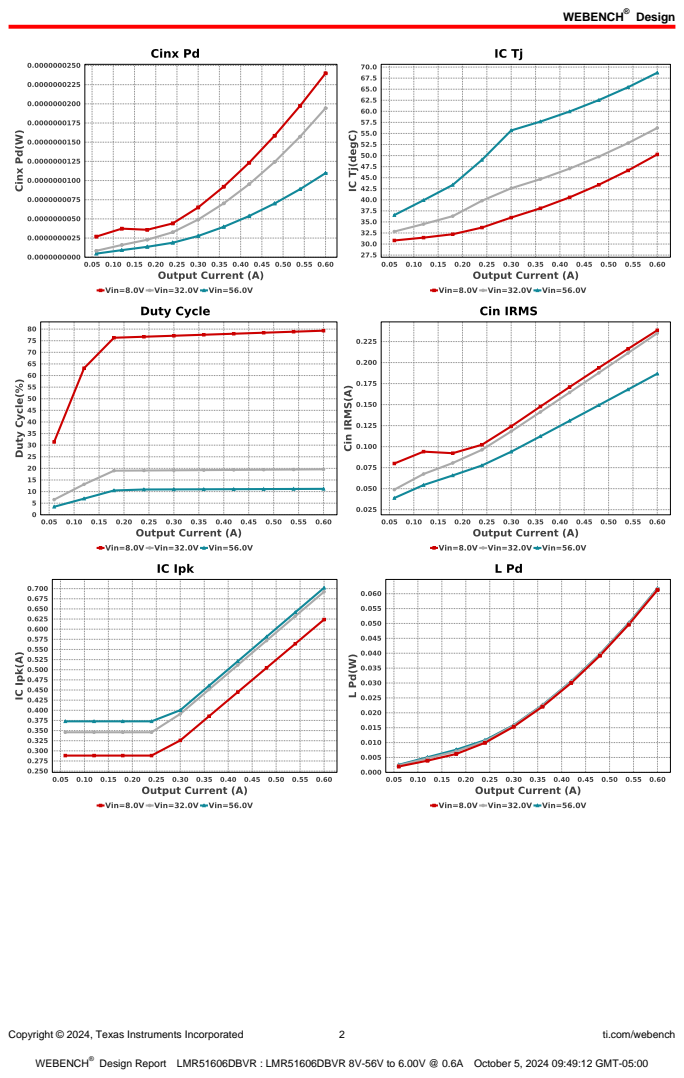
[picture p39: page 2]
Design; Copyright © 2024, Texas Instruments Incorporated; ti.com/webench

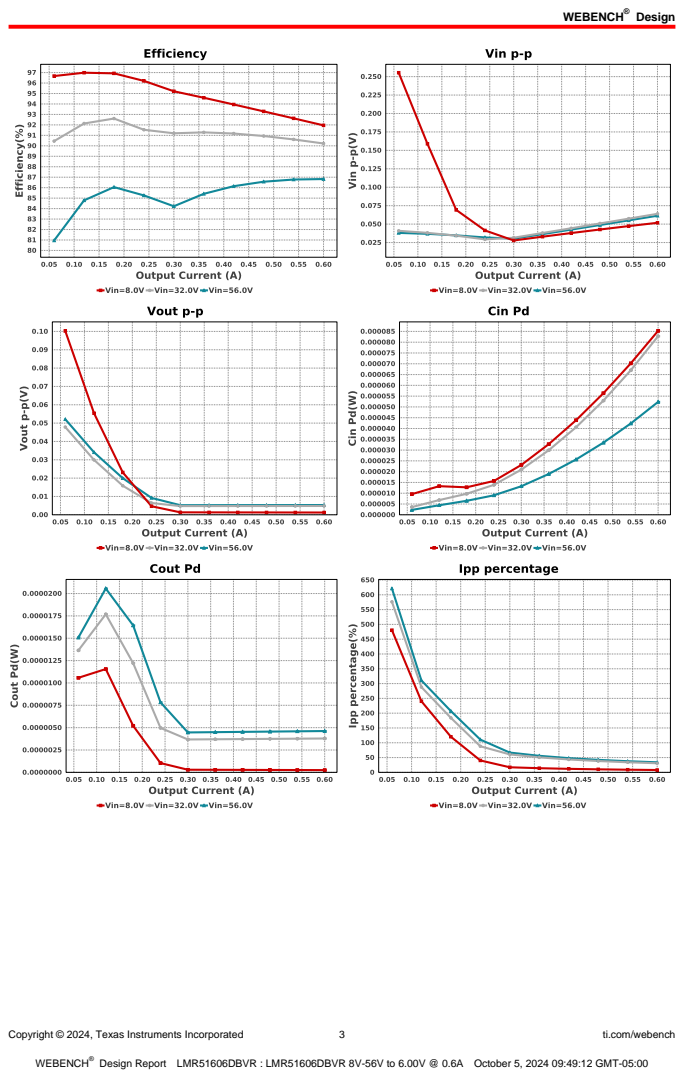
[picture p40: page 3]
Copyright © 2024, Texas Instruments Incorporated; ti.com/webench

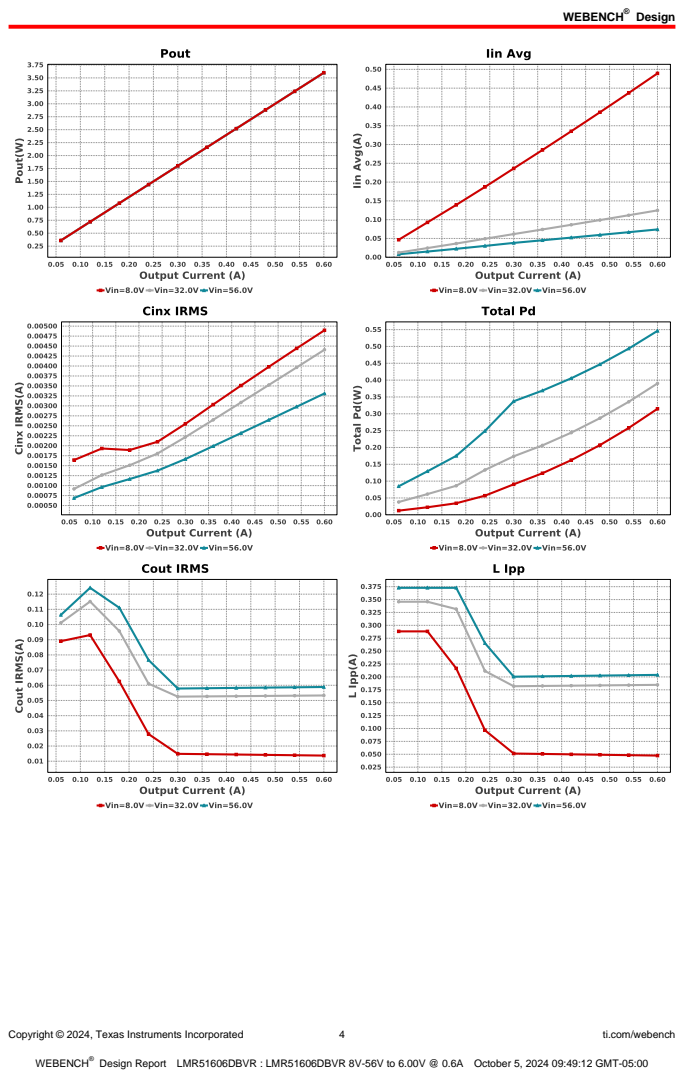
[picture p41: page 4]
Copyright © 2024, Texas Instruments Incorporated; ti.com/webench

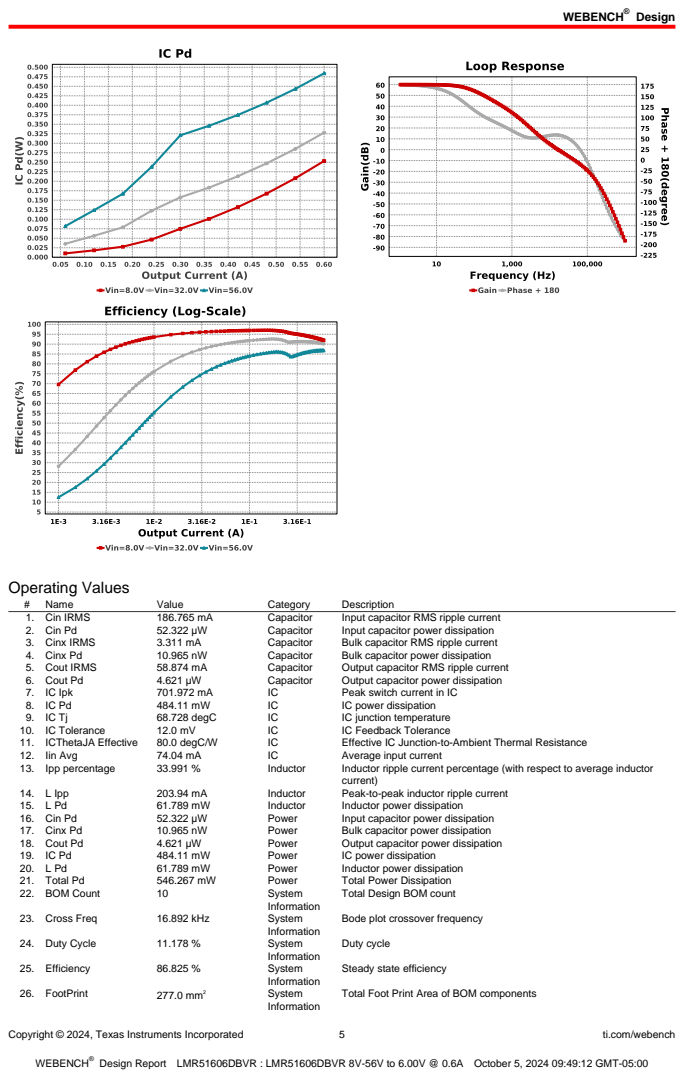
[picture p42: page 5]
Copyright © 2024, Texas Instruments Incorporated; ti.com/webench; Operating Values; Name; Value; Category; Description; 1. Cin IRMS; Capacitor; Input capacitor RMS ripple current; 2. Cin Pd; Input capacitor power dissipation; 3. Cinx IRMS; Bulk capacitor RMS ripple current; 4. Cinx Pd; Bulk capacitor power dissipation; 5. Cout IRMS; Output capacitor RMS ripple current; 6. Cout Pd; Output capacitor power dissipation; 7. IC Ipk; Peak switch current in IC; IC power dissipation; 68.728 degC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

Total Design BOM count

Bode plot crossover frequency

Steady state efficiency

Total Foot Print Area of BOM components

Copyright © 2024, Texas Instruments Incorporated | 6 | ti.com/webench
# | Name | Value | Category | Description

27. Frequency | 400.0 kHz | System
| | | Information | Switching frequency
28. Gain Marg | -18.444 dB | System
| | | Information | Bode Plot Gain Margin
29. Inductor ripple current
| requirement used for Inductor selection | 40.0 % | System Information | Custom Inductor ripple current (% of average inductor current) requirement used for Inductor selection
30. Iout | 600.0 mA | System
| | | Information | Iout operating point
31. Iout transient step used
| for Cout calculations | 300.0 mA | System Information | Custom Transient current step requirement that was used for Cout selection (A).
32. Low Freq Gain | 59.935 dB | System
| | | Information | Gain at 1Hz
33. Mode | CCM | System
| | | Information | Conduction Mode
34. Overshoot Value | 42.547 mV | System
| | | Information | Theoretical Vout Overshoot Value
35. Phase Marg | 59.608 deg | System
| | | Information | Bode Plot Phase Margin
36. Pout | 3.6 W | System
| | | Information | Total output power
37. Total BOM | $1.7 | System
| | | Information | Total BOM Cost
38. Undershoot Value | 60.972 mV | System
| | | Information | Theoretical Vout Undershoot Value
39. Vin | 56.0 V | System
| | | Information | Vin operating point
40. Vin p-p | 61.368 mV | System
| | | Information | Peak-to-peak input voltage
41. Vout | 6.0 V | System
| | | Information | Operational Output Voltage
42. Vout Actual | 5.995 V | System
| | | Information | Vout Actual calculated based on selected voltage divider resistors
43. Vout Ripple
| requirement used for Cout calculations | 3.0 % | System Information | Custom maximum output ripple requirement that was used for Cout selection(% of Vout).
44. Vout Tolerance | 3.277 % | System
| | | Information | Vout Tolerance based on IC Tolerance (no load) and voltage divider resistors if applicable
45. Vout p-p | 5.326 mV | System
| | | Information | Peak-to-peak output ripple voltage
46. Vout transient
| requirement used for Cout calculations | 3.0 % | System Information | Custom Transient voltage change requirement that was used for Cout selection (% of Vout).

## Design Inputs

Name | Value | Description
| Iout | | 600.0 m | Maximum Output Current
VinMax | 56.0 | Maximum input voltage
VinMin | 8.0 | Minimum input voltage
Vout | 6.0 | Output Voltage
| base_pn | | LMR51606 | Base Product Number
source | DC | Input Source Type
Ta | 30.0 | Ambient temperature


Copyright © 2024, Texas Instruments Incorporated | 7 | ti.com/webench

## Assembly

## Component Testing

Some published data on components in datasheets such as Capacitor ESR and Inductor DC resistance is based on conservative values that will guarantee that the components always exceed the specification. For design purposes it is usually better to work with typical values. Since this data is not always available it is a good practice to measure the Capacitance and ESR values of Cin and Cout, and the inductance and DC resistance of L1 before assembly of the board. Any large discrepancies in values should be electrically simulated in WEBENCH to check for instabilities and thermally simulated in WebTHERM to make sure critical temperatures are not exceeded.

## Soldering Component to Board

If board assembly is done in house it is best to tack down one terminal of a component on the board then solder the other terminal. For surface mount parts with large tabs, such as the DPAK, the tab on the back of the package should be pre-tinned with solder, then tacked into place by one of the pins. To solder the tab town to the board place the iron down on the board while resting against the tab, heating both surfaces simultaneously. Apply light pressure to the top of the plastic case until the solder flows around the part and the part is flush with the PCB. If the solder is not flowing around the board you may need a higher wattage iron (generally 25W to 30W is enough).

## Initial Startup of Circuit

It is best to initially power up the board by setting the input supply voltage to the lowest operating input voltage 8.0V and set the input supply's current limit to zero. With the input supply off connect up the input supply to Vin and GND. Connect a digital volt meter and a load if needed to set the minimum Iout of the design from Vout and GND. Turn on the input supply and slowly turn up the current limit on the input supply. If the voltage starts to rise on the input supply continue increasing the input supply current limit while watching the output voltage. If the current increases on the input supply, but the voltage remains near zero, then there may be a short or a component misplaced on the board. Power down the board and visually inspect for solder bridges and recheck the diode and capacitor polarities. Once the power supply circuit is operational then more extensive testing may include full load testing, transient load and line tests to compare with simulation results.

## Load Testing

The setup is the same as the initial startup, except that an additional digital voltmeter is connected between Vin and GND, a load is connected between Vout and GND and a current meter is connected in series between Vout and the load. The load must be able to handle at least rated output power + 50% ( 7.5 watts for this design). Ideally the load is supplied in the form of a variable load test unit. It can also be done in the form of suitably large power resistors. When using an oscilloscope to measure waveforms on the prototype board, the ground leads of the oscilloscope probes should be as short as possible and the area of the loop formed by the ground lead should be kept to a minimum. This will help reduce ground lead inductance and eliminate EMI noise that is not actually present in the circuit.

## Design Assistance

1. Master key : E03FC439211E3F9A5803B0C08B508BCF[v1]
2. LMR51606 Product Folder : http://www.ti.com/product/LMR51606 : contains the data sheet and other resources.

Copyright © 2024, Texas Instruments Incorporated | 8 | ti.com/webench

Important Notice and Disclaimer

TI provides technical and reliability data (including datasheets), design resources (including reference designs), application or other design advice, web tools, safety information, and other resources AS IS and with all faults, and disclaims all warranties. These resources are intended for skilled developers designing with TI products. You are solely responsible for (1) selecting the appropriate TI products for your application, (2) designing, validating and testing your application, and (3) ensuring your application meets applicable standards, and any other safety, security, or other requirements.

These resources are subject to change without notice. TI grants you permission to use these resources only for development of an application that uses the TI products described in the resource. Other reproduction and display of these resources is prohibited. No license is granted to any other TI intellectual property right or to any third party intellectual property right. TI disclaims responsibility for, and you will fully indemnify TI and its representatives against, any claims, damages, costs, losses, and liabilities arising out of your use of these resources.

Providing these resources does not expand or otherwise alter TI's applicable Terms of Sale or other applicable terms available either on ti.com or provided in conjunction with TI products.
