Mateushga1/Buck-Boost-Converter/Simulations/Buck-Boost/Buck_Boost.asc

C1: cap; 100n
C2: cap; .1µ
C3: cap; .1µ
C4: cap; 4.7µ
C5: cap; .47µ
C6: cap; 10n
C7: cap; 10µ; x3; V=100 Irms=0 Rser=0.003 Lser=1.2n mfg="Würth Elektronik" pn="885012214001 WCAP-CSGP 2220" type="X7R"
C8: polcap; 100µ; x3; V=63 Irms=650m Rser=0.12 Lser=0
C9: cap; 1µ
C10: cap; 1µ
C11: cap; 10µ; x3; V=100 Irms=0 Rser=0.003 Lser=1.2n mfg="Würth Elektronik" pn="885012214001 WCAP-CSGP 2220" type="X7R"
C12: polcap; 100µ; x3; V=63 Irms=650m Rser=0.12 Lser=0
D1: zener; BZX84B10VLY
D2: LED; NSCW100
D3: LED; NSCW100
D4: LED; NSCW100
L1: ind; 6.8µ; Ipk=44 Rser=1.31m Cpar=0
M1: nmos; IRLH5036
M2: nmos; IRLH5036
M3: nmos; IRLH5036
M4: nmos; IRLH5036
M5: nmos; IRLH5036
R1: res; 1.6m
R2: res; 100k
R3: res; 820k
R4: res; 18.7k
R5: res; 330
R6: res; 45.3K; tol=1 pwr=0.1
R7: res; 249K; tol=1 pwr=0.1
R8: res; 73.2k
R9: res; 2k2
R10: res; 1.5
R11: res; 102K; tol=1 pwr=0.1
R12: res; 10K; tol=1 pwr=0.1
R13: res; 100K; tol=1 pwr=0.1
R14: res; 3.32K; tol=1 pwr=0.1
R21: res; 0.003
U1: LT8390
V1: voltage; 12
V3: voltage; 2.5
Named nets: 0, OUT, Vcontrol, INTVcc, FB_IN, ISP, ISN
.tran 0 120m 0.2m startup uic
