Mateushga1/Buck-Boost-Converter/Simulations/Complete/FB_Signal_Control.asc

C1: cap; 10n
C2: cap; .1µ
C3: cap; 1n
C4: cap; 1n
C5: cap; 100n
C6: cap; 100n
C7: cap; 100n
I1: current; 12m
Q1: npn; 2N2222
Q2: pnp; 2N5771
R1: res; 75K; tol=1 pwr=0.1
R2: res; 280k
R3: res; 1Meg
R4: res; 1k
R5: res; 1k
R6: res; 10k
R7: res; 10k
R8: res; 10k
R9: res; 10k
R10: res; 187K; tol=1 pwr=0.1
R11: res; 3.4K; tol=1 pwr=0.1
R12: res; 499K; tol=1 pwr=0.1
R14: res; 100k; tol=1 pwr=0.1
R15: res; 1k; tol=1 pwr=0.1
R16: res; 250
R17: res; 100k
R18: res; 100k
R19: res; 100k
R20: res; 250
R21: res; 20K; tol=1 pwr=0.1
R22: res; 5.11K; tol=1 pwr=0.1
R23: res; 100k
R24: res; 150; tol=1 pwr=0.1
R25: res; 102k; tol=1 pwr=0.1
Rbias1: res; 768; tol=1 pwr=0.1
Rbias2: res; 768; tol=1 pwr=0.1
U1: LTC6992-1
U2: AD8532
U3: ADR5045
U4: AD8532
U5: ADR5045
U6: AD8532
U7: AD8532
U8: CNR200
U9: AD8532
U10: AD8532
V3: voltage; 28
V4: voltage; 5.5
V5: voltage; 6
V6: voltage; 5
Named nets: PWMout, 0, Vs, FB_Control, 5V_ref, FB_IN, in, COM, Viso, Control_Signal, 5Viso_ref, Mode_Buck_Boost, Mode_Buck
.tran 500m uic
Colocar um potenciômetro 1k em R6
Colocar um potenciômetro 20k em R16
