Mateushga1/Buck-Boost-Converter/Simulations/FB_Control/FB_Control.asc

C3: cap; 10n
C4: cap; .1µ
Q1: npn; 2N2222
R1: res; 75K; tol=1 pwr=0.1
R2: res; 280k
R3: res; 1Meg
R4: res; 187K; tol=1 pwr=0.1
R5: res; 1k
R7: res; 1k
R10: res; 10k
R11: res; 10k
R12: res; 10k
R13: res; 10k
R14: res; 3.4K; tol=1 pwr=0.1
R15: res; 499K; tol=1 pwr=0.1
Rbias1: res; 768; tol=1 pwr=0.1
U1: LTC6992-1
U2: AD8531
U4: ADR5045
U5: AD8531
V1: voltage; 5.5
V3: voltage; 5
V4: voltage; 12
Named nets: 0, PWMout, Vcc, Vcontrol, 5V_ref, ctrl, FB_IN, in
.tran 500m startup
