Mateushga1/Buck-Boost-Converter/Simulations/Iso_Analog_Input/Iso_Analog_Input.asc

C1: cap; 100n
C2: cap; 100n
C3: cap; 1n
C4: cap; 1n
I1: current; 20m
Q1: pnp; 2N5771
R2: res; 100Meg
R5: res; 100k; tol=1 pwr=0.1
R6: res; 1k; tol=1 pwr=0.1
R7: res; 250
R8: res; 100k
R9: res; 100k
R10: res; 100k
R11: res; 250
R12: res; 20K; tol=1 pwr=0.1
R13: res; 5.11K; tol=1 pwr=0.1
R14: res; 100k
R15: res; 150; tol=1 pwr=0.1
R16: res; 102k; tol=1 pwr=0.1
Rbias1: res; 768; tol=1 pwr=0.1
U4: AD8532
U5: AD8532
U9: ADR5045
U10: CNR200
U11: AD8532
U12: AD8532
V1: voltage; 5.5
V2: voltage; 6
V3: voltage; 5
Named nets: 0, COM, Viso, Vs, Vcontrol, 5V_ref, Vout
.tran 0 6 0.1 uic
Colocar um potenciômetro 1k em R6
Colocar um potenciômetro 20k em R16
