Mateushga1/Buck-Boost-Converter/Simulations/Main_Source/LM5160_fly-buck.asc

C1: cap; 0.22µ; V=100 Irms=0 Rser=0 Lser=0 mfg="Murata" pn="GCM31MR72A224KA37" type="X7R"
C2: cap; 0.027µ; V=100 Irms=0 Rser=0 Lser=0 mfg="Murata" pn="GCM21BR72A273KA37" type="X7R"
C3: cap; 1µ; V=100 Irms=0 Rser=0.0053 Lser=651p mfg="Würth Elektronik" pn="885012209069 WCAP-CSGP 1210" type="X7R"
C4: cap; 1µ; V=16 Irms=0 Rser=0.007 Lser=0 mfg="TDK" pn="C3216X7RIC105K" type="X7R"
C5: cap; 0.01µ; V=16 Irms=272m Rser=0.391699 Lser=0 mfg="KEMET" pn="C0805C103K4RAC" type="X7R"
C6: cap; 0.1µ; V=16 Irms=0 Rser=0 Lser=0 mfg="Murata" pn="GCM155R71C104KA55" type="X7R"
C7: cap; 0.0051µ; V=50 Irms=0 Rser=0 Lser=0 mfg="Murata" pn="GCM1885C1H512JA16" type="C0G"
C8: cap; 47µ; V=16 Irms=0 Rser=0 Lser=0 mfg="Murata" pn="GRM31CR61C476ME44" type="X5R"
C10: cap; 2.2n
C12: cap; 47µ; V=16 Irms=0 Rser=0 Lser=0 mfg="Murata" pn="GRM31CR61C476ME44" type="X5R"
D1: schottky; DI_DFLS1100
I1: current; PWL(0 0 12m 0 12.1m 0.05)
I2: current; PWL(0 0 12m 0 12.1m 0.2)
L1: ind2; 100µ; Rser=113m
L2: ind2; 100µ; Rser=113m
R1: res; 133k
R2: res; 23.7k
R3: res; 162k
R4: res; 13k
R5: res; 3.57K; tol=1 pwr=0.1
R6: res; 2k
R7: res; 0
R8: res; 0
R10: res; 1G
U1: LM5160
U2: pot; R=1k; T=.26
V1: voltage; 12
Named nets: 0, 5.5V_Viso, 6V_Vs, ss, Vin
K1 L1 L2 1
.tran 40m startup
.ic V(ss)=2.2
.inc lm5160-new.lib
.inc DFLS1100.spice.txt
ISO
GND
.opt plotwinsize=0
Vs = 5.85
Viso = 5.37
