Mateushga1/Buck-Boost-Converter/Simulations/Polarity_Protection/Polarity_Protection.asc

D1: zener; BZX84B10VLY
D2: LED; NSCW100
D3: LED; NSCW100
D4: zener; BZX84B10VLY
D5: LED; NSCW100
D6: LED; NSCW100
M1: pmos; Si7461DP
M2: nmos; IRLH5036
R1: res; 100k
R2: res; 11.2
R3: res; 3.3k
R4: res; 100k
R5: res; 3.3k
R6: res; 11.2
V1: battery; 56
V2: battery; 56
Named nets: 0
.tran 1
