Mateushga1/Buck-Boost-Converter/(list of files, drawings)

Other design files:
PCB/FB_Control.SchDoc
PCB/Main_Power_Supply.SchDoc
PCB/Portolan_Buck_Boost_V2.PrjPcb
PCB/Power_Stage.SchDoc
