Mateushga1/Buck-Boost-Converter/(commit log)

2025-06-15 Buck Boost Final
    [Calculo_Buck_Boost.xlsx, Dimensionamento_Variação_Tensão.xlsx, LM5160A_calculator.xlsx, Linearity_Verification.xlsx, Programmation_Tension_Sortie.xlsx, T-Y10W732956A-1sets-BOM_Portolan_Buck_Boost_V2(2024-12-02).xls, Verification_Linearite.xlsx, Vout_Program.xlsx]
2025-06-15 Add Altium FIles
    [FB_Control.SchDoc, Main_Power_Supply.SchDoc, Portolan_Buck_Boost_V2.PrjPcb, Power_Stage.SchDoc]
